Silviuu24/TUCN-Analog-Circuits-SCIA/Photo/Circuit.jpg

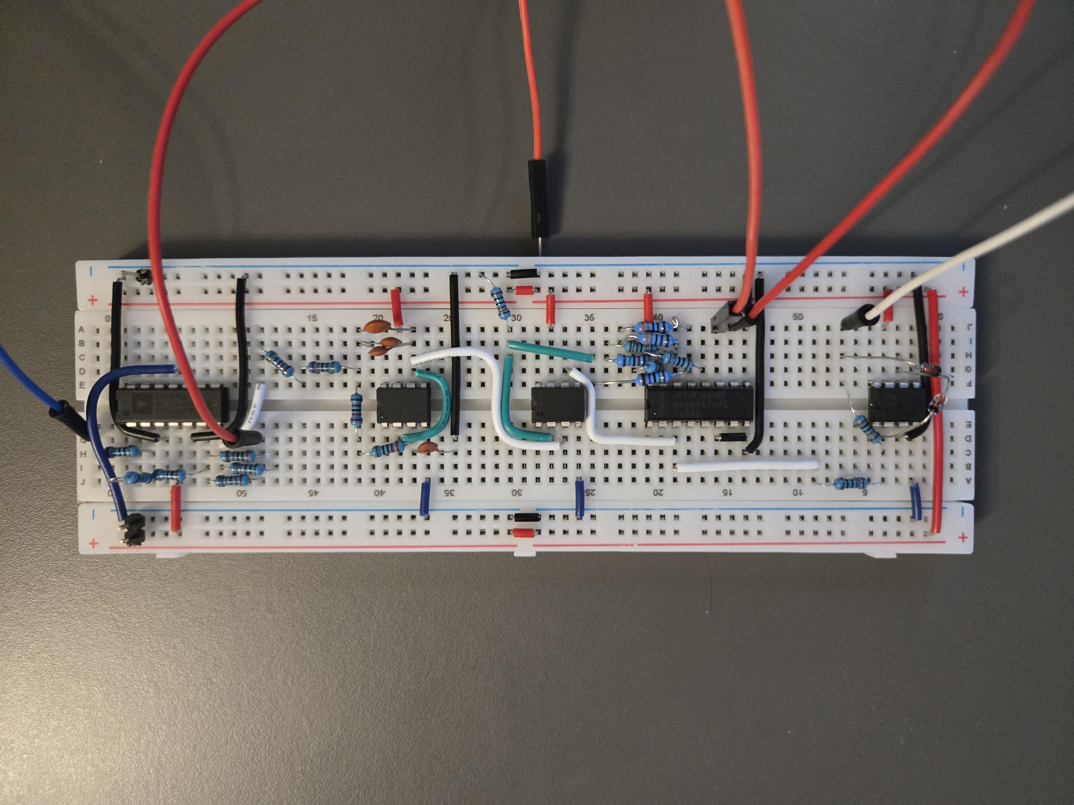
Photo/Circuit.jpg
