Silviuu24/TUCN-Analog-Circuits-SCIA/Docs/Proiect SCIA.pdf

# PROIECT SCIA

# SEMESTRUL I

2026

# Student: Șișca Silviu-Claudiu

Anul: III, 2133;

### Cuprins

## 1. Tematica proiectului

Să se proiecteze un circuit electric format din 4 etaje :

- Etajul 1 : - sursa de semnal este o sursă de tensiune diferențială
- amplitudinea minimă (pentru câștig maxim PGA): 0.116 [V]
- amplitudinea maximă (pentru câștig minim PGA): 0.232 [V]
- amplificator de instrumentație cu 2 AO , inversor
- câștigul etajului este 3
- Etajul 2 : - filtru Sallen-Key Low Pass
- câștigul liniar în banda de trecere este 1
- rezistența de intrare minimă este de 750 [Ω]
- banda filtrului este de 7000 [Hz]
- factorul de calitate Q este 1
- Etajul 3 : - amplificator cu câștig programabil, conexiune serie, neinversor
- câștigul minim este 8 [dB]
- rezoluția este 2 [dB]
- numărul de pași este 4
- câștigul maxim este 14 [dB]
- Etajul 4 : - redresor monoalternanță, alternanța pozitivă este amplificată
- câștigul etajului este 2

Pentru realizarea acestui circuit se vor folosi Amplificatoare Operaționale LT1679

## 2. Dimensionarea circuitului

### 2.1. Dimensionarea etajului 1

Etajul 1, ilustrat în figura 1, este un amplificator operațional cu alimentare diferențială. Trebuie dimensionate rezistențele R1, R2, R3, R4 și R5 pentru funcționarea corectă și pentru obținerea câștigului dorit.

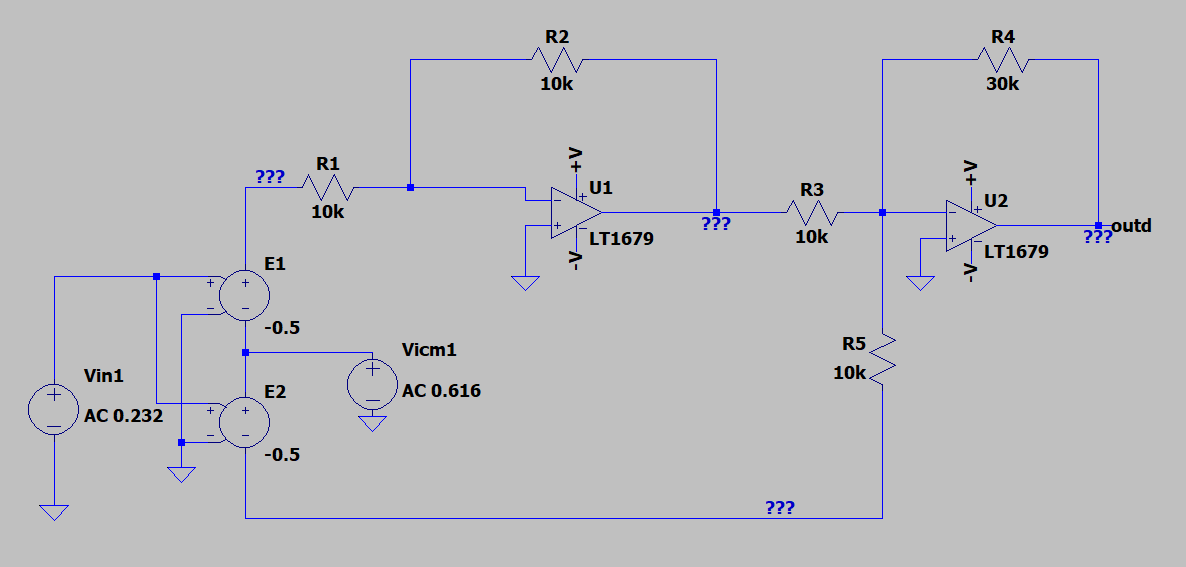
[picture p2: figure]

### Figura 1: Etajul 1 – Amplificatorul de instrumentație

Formula tensiunii de ieșire este reprezentată de relația (1).

Vout =

R2R4
R1R3

VA −

R4
R5

VB
(1)

Pentru ca circuitul să funcționeze ca amplificator de instrumentație trebuie respectate relațiile (2) și (3) rezultând relația (4).

Vout = AD(VA − VB) + Vref | (2)

RinA = RinB
RinA = R1
RinB = R5

(3)

R1 = R5
R2 = R3

(4)

Pentru a obține câștigul precizat, AD = 3 , rezistența R4 trebuie să fie de 3 ori mai mare decât rezistența R5.
R4 = 3R5
(4)

Alegem R5 = 10 kΩ și R2 = 10 kΩ.
Rezultă că R1 = R2 = R3 = R5 = 10 kΩ și R4 = 30 kΩ.

### 2.2. Dimensionarea etajului 2

Etajul 2, ilustrat în figura 2, este un filtru Sallen-Key Low Pass. Trebuie dimensionate rezistențele R1, R2 și condensatoarele C1, C2 .

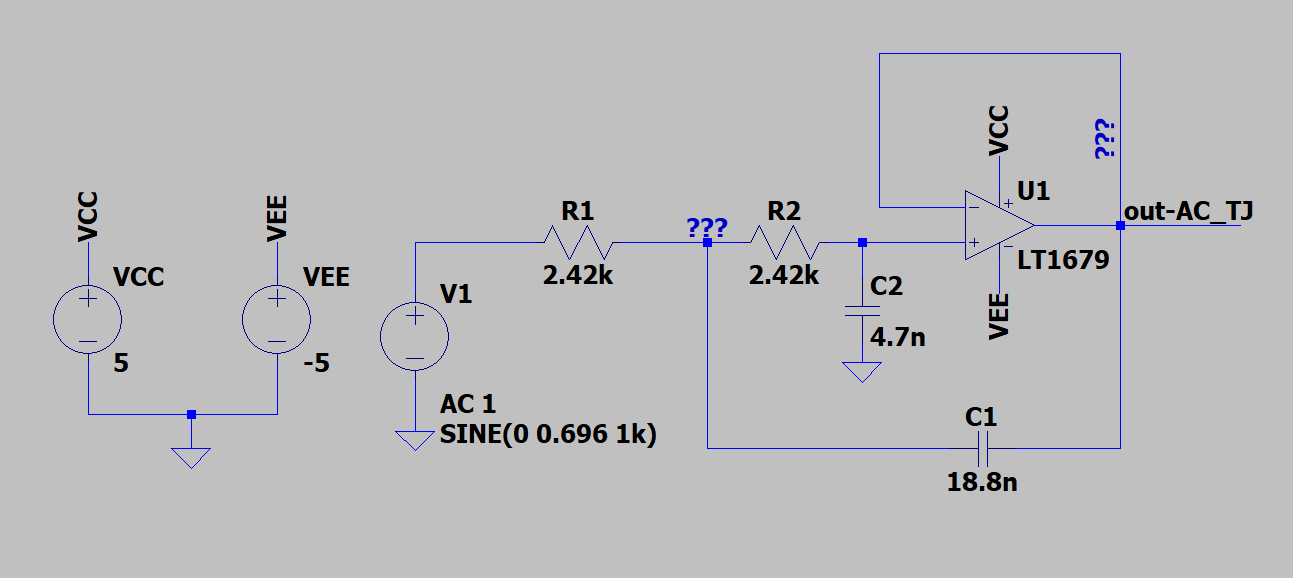
[picture p3: figure]

### Figura 2: Etajul 2 – Filtrul Sallen-Key Low Pass

Pentru dimensionarea circuitului, astfel încât să obținem câștig liniar în banda de trecere egal cu 1, banda de 7000 [Hz] și factorul de calitate Q egal cu 1, am folosit relațiile prezentate în figura 3.

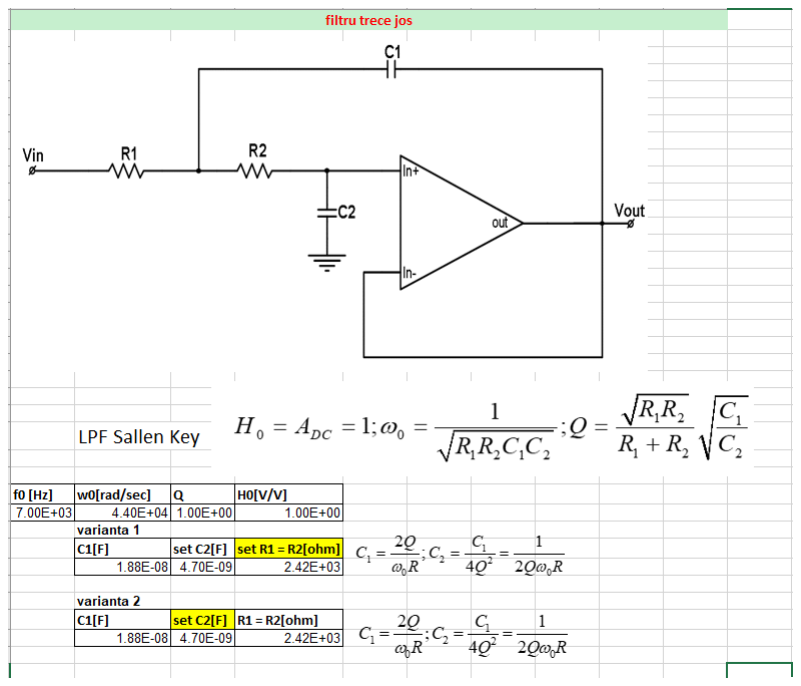
[picture p4: figure]

### Figura 3: Excel pentru dimensionarea etajului

Rezultă că C1 = 18.8 nF, C2 = 4.7 nF și R1 = R2 = 2.42 kΩ.

### 2.3. Dimensionarea etajului 3

Etajul 3, ilustrat în figura 4, este un amplificator cu câștig programabil (PGA), neinversor, conexiune serie, cu 4 variante de amplificare: 8dB, 10dB, 12dB și 14dB. Trebuie dimensionate rezistențele RF1, RF2, RF3, RF4 și RG.

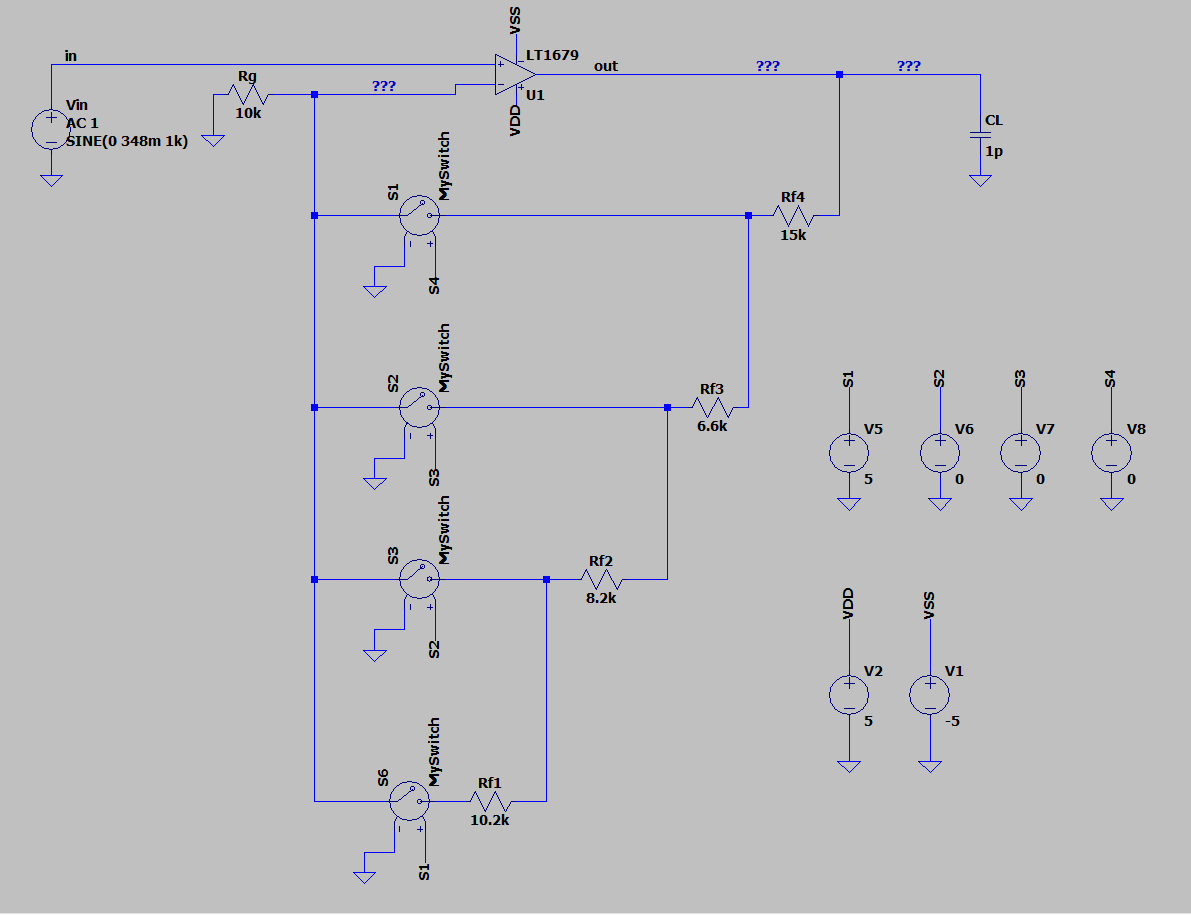
[picture p5: figure]

### Figura 4: Etajul 3 – PGA neinversor, conexiune serie

Formula generală a tensiunii de ieșire este reprezentată de relația (5).

Vout = (1 +

RF
RG
)Vin | (5)

Pentru cazul în care switch-ul de pe ramura cu RF1 este închis vom obține relația (6) și o amplificare AV = 14dB ≃ 5

Vout = (1 +

RF1 + RF2 + RF3 + RF4
RG
)Vin | (6)

Pentru cazul în care switch-ul de pe ramura cu RF2 este închis vom obține relația (7) și o amplificare AV = 12dB ≃ 3.98

Vout = (1 +

RF2 + RF3 + RF4
RG
)Vin | (7)

Pentru cazul în care switch-ul de pe ramura cu RF3 este închis vom obține relația (8) și o amplificare AV = 10dB ≃ 3.16

Vout = (1 +

RF3 + RF4
RG
)Vin | (8)

Pentru cazul în care switch-ul de pe ramura cu RF4 este închis vom obține relația (9) și o amplificare AV = 8dB ≃ 2.5

Vout = (1 +

RF4
RG
)Vin | (9)

Egalând formulele ampificărilor cu valorile corespunzătoare rezultă:

1 +

RF4
RG

= 2.5

1 +

RF3 + RF4
RG

= 3.16

1 +

RF2+RF3 + RF4
RG

= 3.98

1 +

RF1 + RF2 + RF3 + RF4
RG

= 5

(10)

Din relațiile de la (10) putem găsi valorile rezistențelor RF1, RF2, RF3 și RF4 în funcție de RG.

RF4 = 1.5RG

RF3 = 0.66RG

RF2 = 0.82RG

RF1 = 1.02RG

(11)

Alegem RG = 10 kΩ .
Rezultă că RF1 = 10.2 kΩ, RF2 = 8.2 kΩ, RF3 = 6.6 kΩ, RF4 = 15 kΩ.

### 2.4. Dimensionarea etajului 4

Etajul 4, ilustrat în figura 5, este un redresor monoalternanță care amplifică alternanța pozitivă. Trebuie dimensionate rezistențele R1 și R2 pentru a obține un câștig AV egal cu 2.

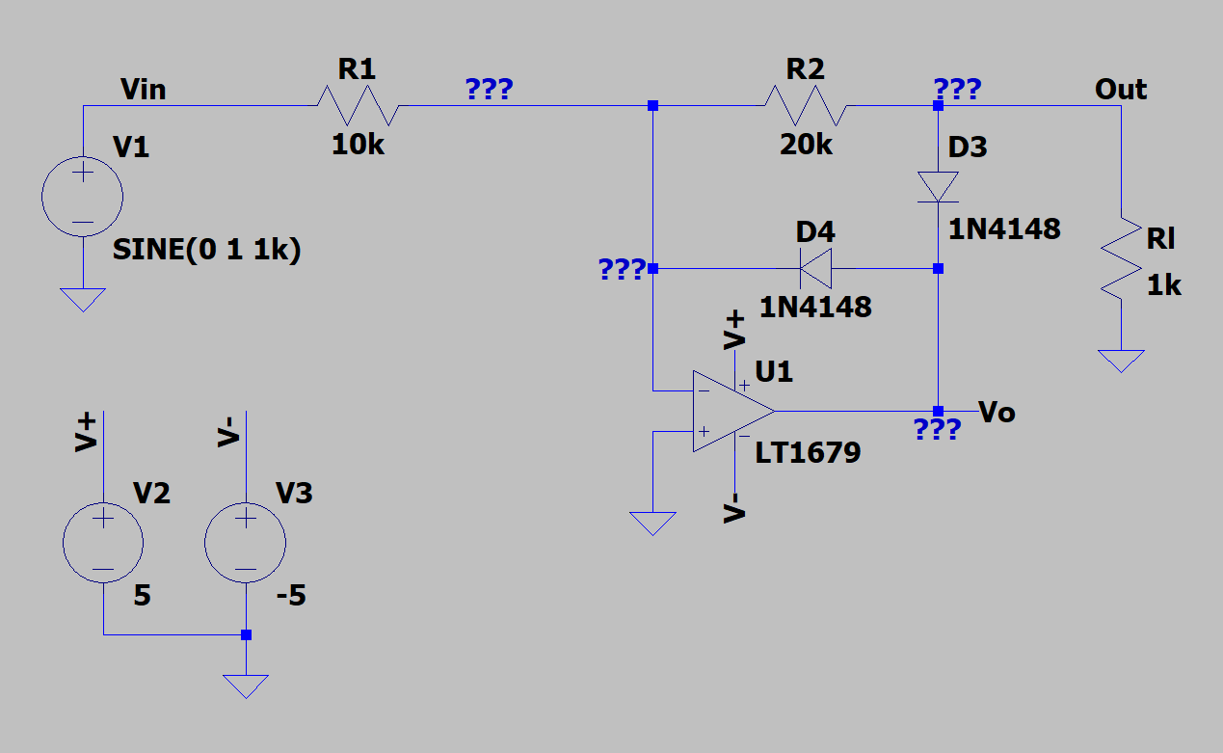
[picture p6: figure]

### Figura 5: Etajul 4 – Redresor monoalternanță

Formula tensiunii de ieșire, Vout, când tensiunea de intrare este negativă, Vin ≤ 0, este reprezentată de relația (12).

Vout = 0
(12)

Formula tensiunii de ieșire, Vout, când tensiunea de intrare este pozitivă, Vin > 0, este reprezentată de relația (13).

Vout = −

R2
R1
Vin | (13)

Egalând modulul amplificării din relația (13) cu amplificarea dorită se obține:

R2 = 2R1
(13)

Alegem R1 = 10 kΩ .
Rezultă că R2 = 20 kΩ .

## 3. Caracterizarea circuitului

### 3.1. Caracterizarea etajului 1

### 3.1.1. Punctul static de funcționare

Această simulare ne va arăta starea circuitului la repaus (nu avem semnal de intrare).
În figurile 6 și 7 se observă că, în absența semnalului de intrare, Vin = 0V, tensiunea de ieșire Vout este neglijabilă (2.24 µV), fiind cauzată doar de tensiunea mică de offset a amplificatorului real LT1679. Rezultă că etajul este polarizat corect și nu este saturat.

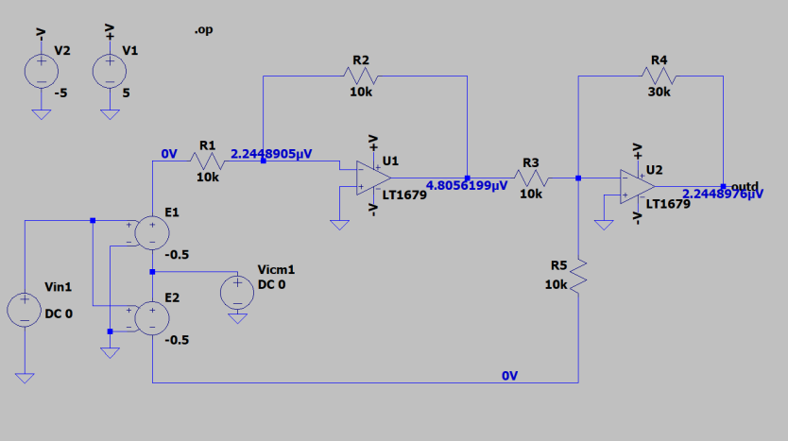
[picture p7: figure]

### Figura 6: Analiza .op asupra circuitului

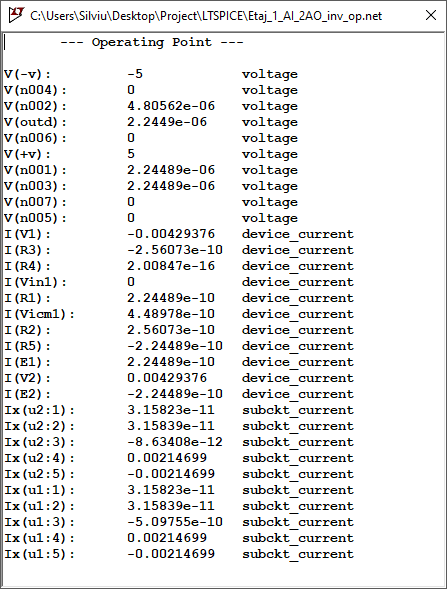
[picture p8: figure]

### Figura 7: Rezultatele analizei .op

### 3.1.2. Analiza AC – câstigul la joasă frecvență, banda, CMRR, PSRR

Cu ajutorul acestei simulări vom putea genera diagramele Bode.
Sintaxa pe care o vom folosi este: “.ac dec 100 .01 10Meg” .

Din figurile 8 și 9 putem afla că: banda etajului este de aproximativ 1.42MHz fiind mult mai mare decât banda filtrului (7kHz), câștigul la joasă frecvență este de aproximativ 9.54dB, adică aproximativ 3.

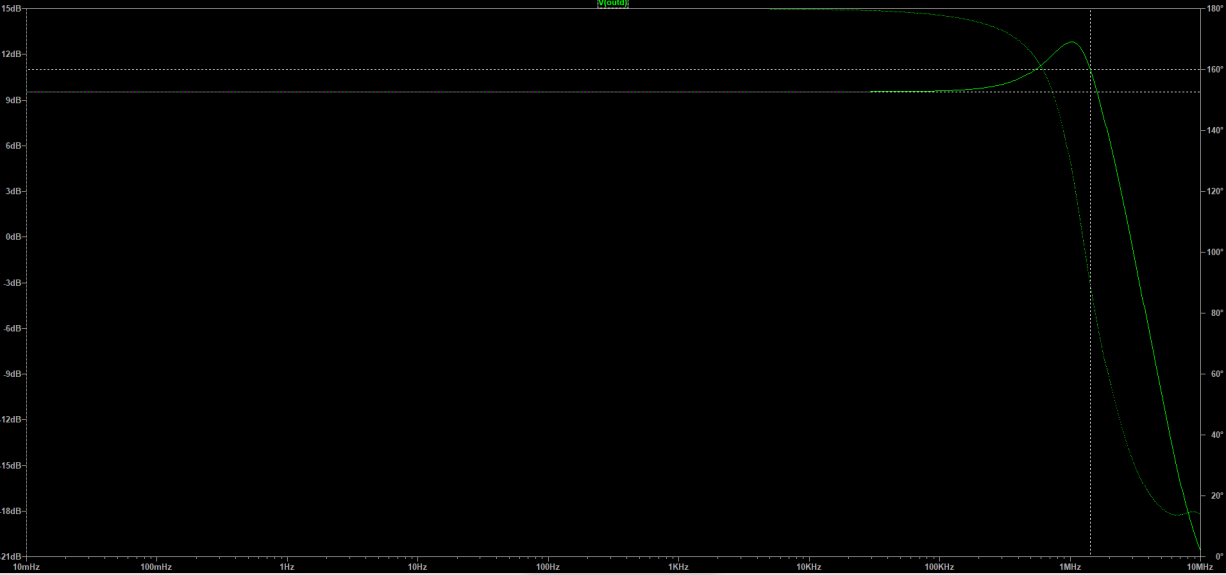
[picture p9: figure]

### Figura 8: Diagrama Bode a etajului

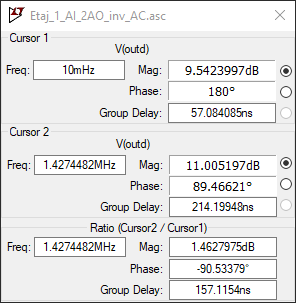
[picture p10: figure]

### Figura 9: Tabelul valorilor pentru cursoare

Pentru a afla CMRR-ul vom folosi circuitul din figura 10.
Din figurile 11 și 12 putem extrage că: CMRR-ul este 109dB la joasă frecvență și aproximativ 48dB la frecvența de 10kHz.

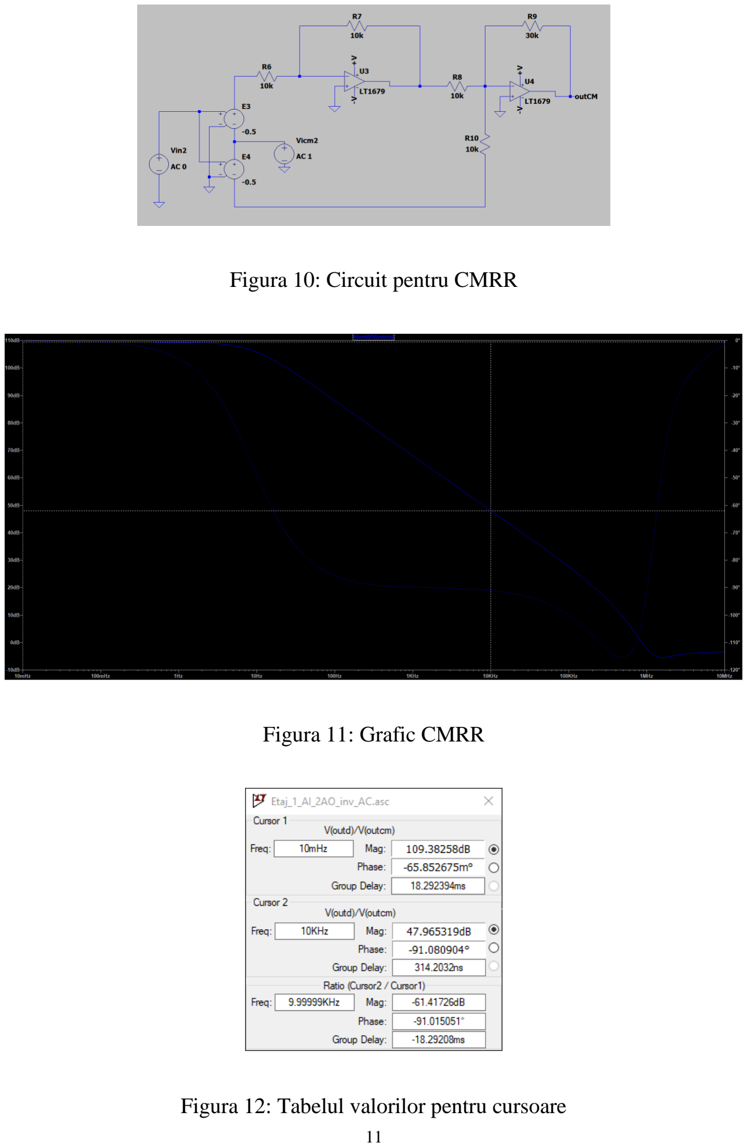
[picture p11: page 11]

### Figura 10: Circuit pentru CMRR

### Figura 11: Grafic CMRR

### Figura 12: Tabelul valorilor pentru cursoare

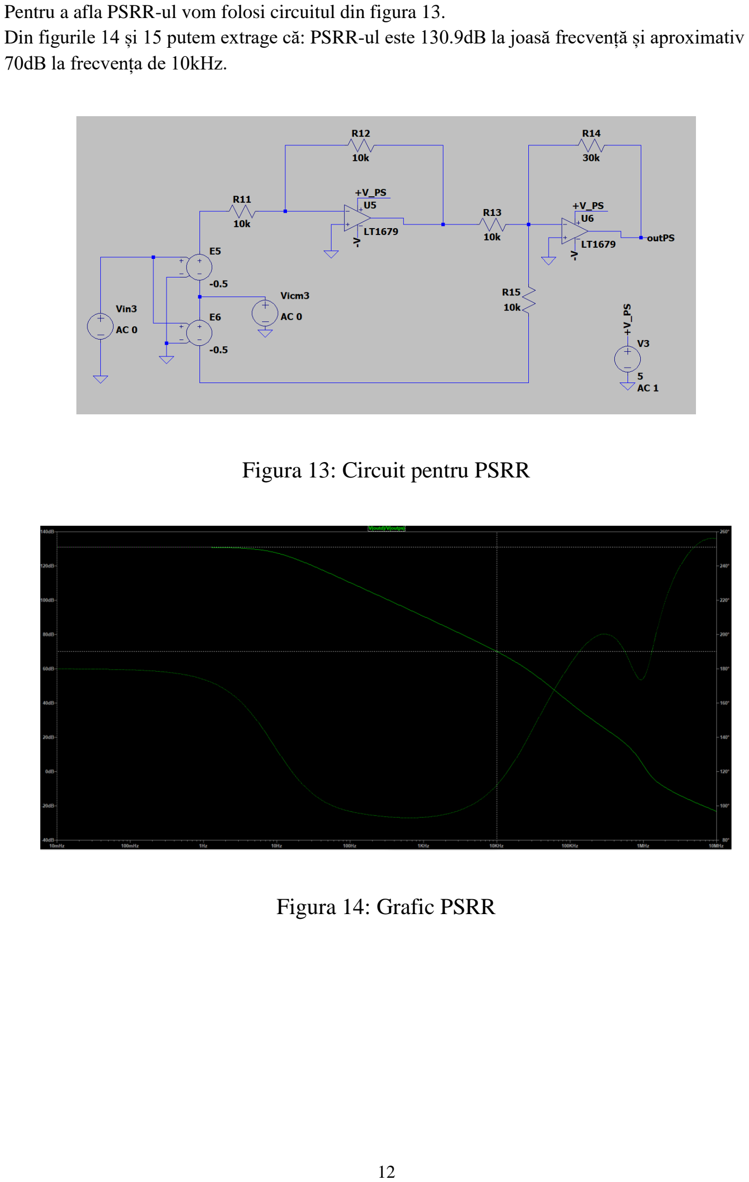
[picture p12: page 12]

Pentru a afla PSRR-ul vom folosi circuitul din figura 13.
Din figurile 14 și 15 putem extrage că: PSRR-ul este 130.9dB la joasă frecvență și aproximativ 70dB la frecvența de 10kHz.

### Figura 13: Circuit pentru PSRR

### Figura 14: Grafic PSRR

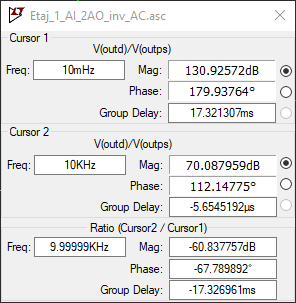
[picture p13: figure]

### Figura 15: Tabelul valorilor pentru cursoare

### 3.1.3. Analiza Transient – SR, liniaritate

Această simulare permite analiza formei de undă a semnalului de ieșire în domeniul timp. Sintaxa pe care o vom folosi este: “.tran 0 10m 0 0.1m” .

În figura 16 aflăm că THD ≃ 0.805% .

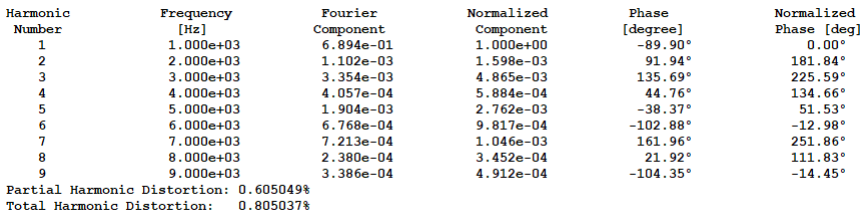
[picture p14: figure]

### Figura 16: Tabel analiză Fourier

În figura 17 putem observa semnalul de intrare Vin în comparație cu semnalul de ieșire Vout, care este inversat și amplificat cu un AV ≃ 3 .

Liniaritatea circuitului este confirmată prin analiza Fourier, prin faptul că semnalul de ieșire este o copie fidelă a semnalului de intrare, fiind amplificat si inversat.

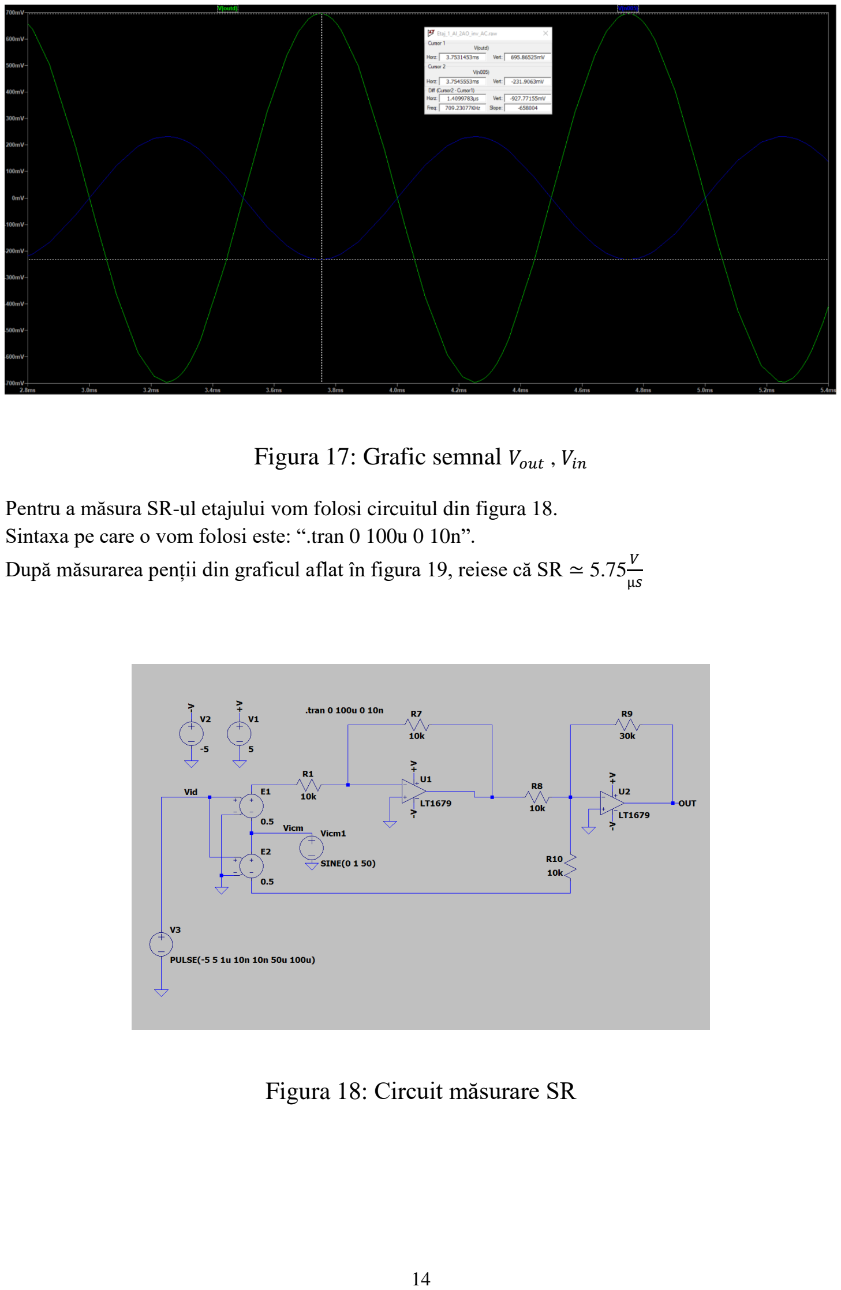
[picture p15: page 14]

### Figura 17: Grafic semnal Vout , Vin

Pentru a măsura SR-ul etajului vom folosi circuitul din figura 18.
Sintaxa pe care o vom folosi este: “.tran 0 100u 0 10n”.
După măsurarea penții din graficul aflat în figura 19, reiese că SR ≃ 5.75 V
µs

### Figura 18: Circuit măsurare SR

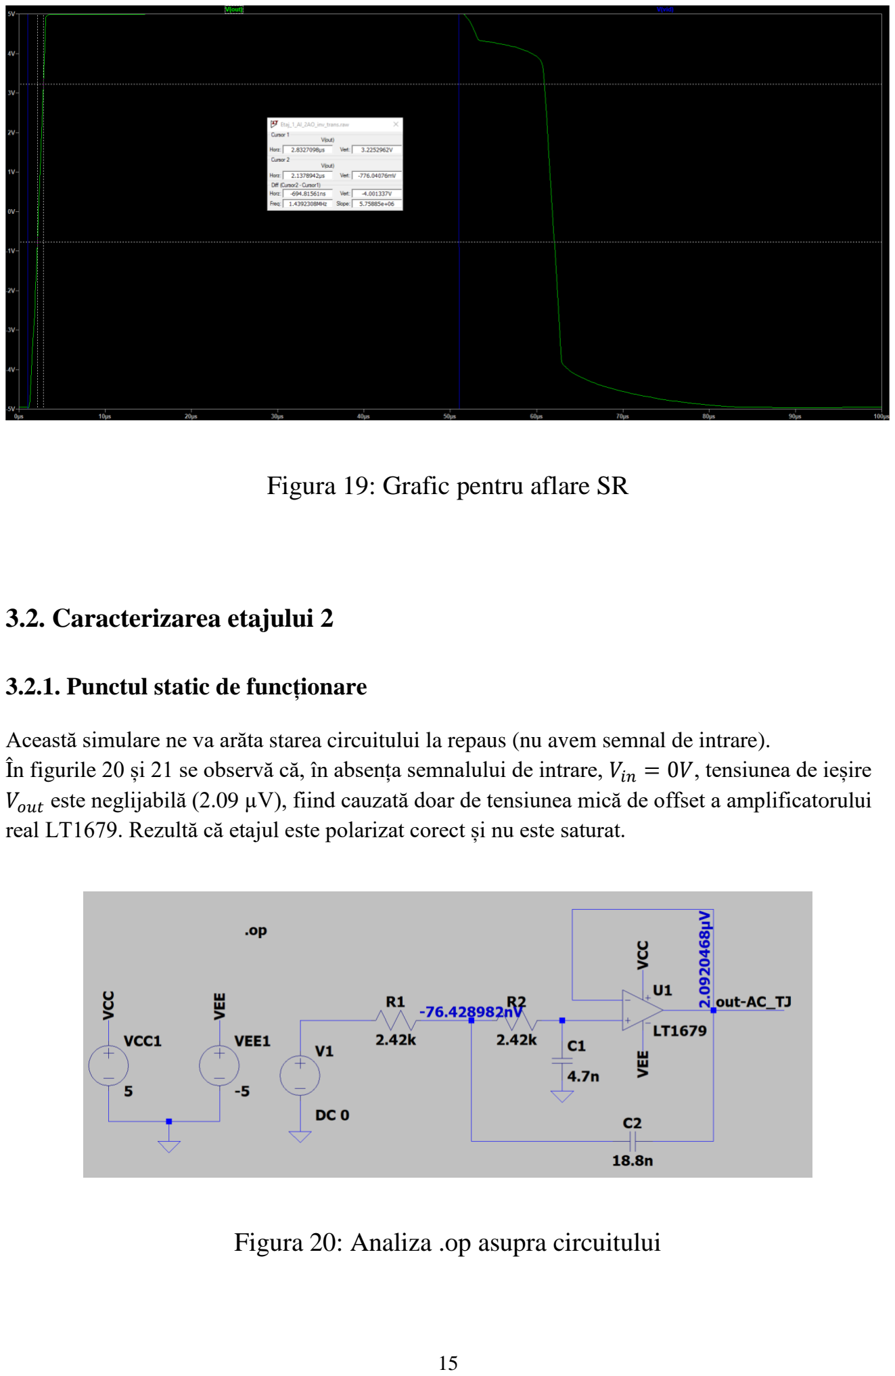
[picture p16: page 15]

### Figura 19: Grafic pentru aflare SR

### 3.2. Caracterizarea etajului 2

### 3.2.1. Punctul static de funcționare

Această simulare ne va arăta starea circuitului la repaus (nu avem semnal de intrare).
În figurile 20 și 21 se observă că, în absența semnalului de intrare, Vin = 0V, tensiunea de ieșire Vout este neglijabilă (2.09 µV), fiind cauzată doar de tensiunea mică de offset a amplificatorului real LT1679. Rezultă că etajul este polarizat corect și nu este saturat.

### Figura 20: Analiza .op asupra circuitului

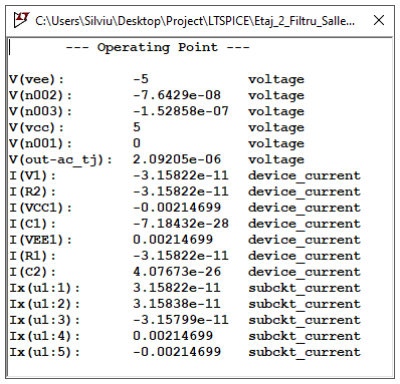
[picture p17: figure]

### Figura 21: Rezultatele analizei .op

### 3.2.2. Analiza AC – câstigul la joasă frecvență, banda

Cu ajutorul acestei simulări vom putea genera diagramele Bode.
Sintaxa pe care o vom folosi este: “.ac oct 100 1 10k” .

Din figurile 22 și 23 putem afla că: banda filtrului este de 7kHz, câștigul în banda de trecere îl putem considera 0dB pe marea majoritate a benzii , acesta având un maxim de 1.2dB la frecvența de 5kHz. Acest maxim este datorat factorului de calitate Q = 1.

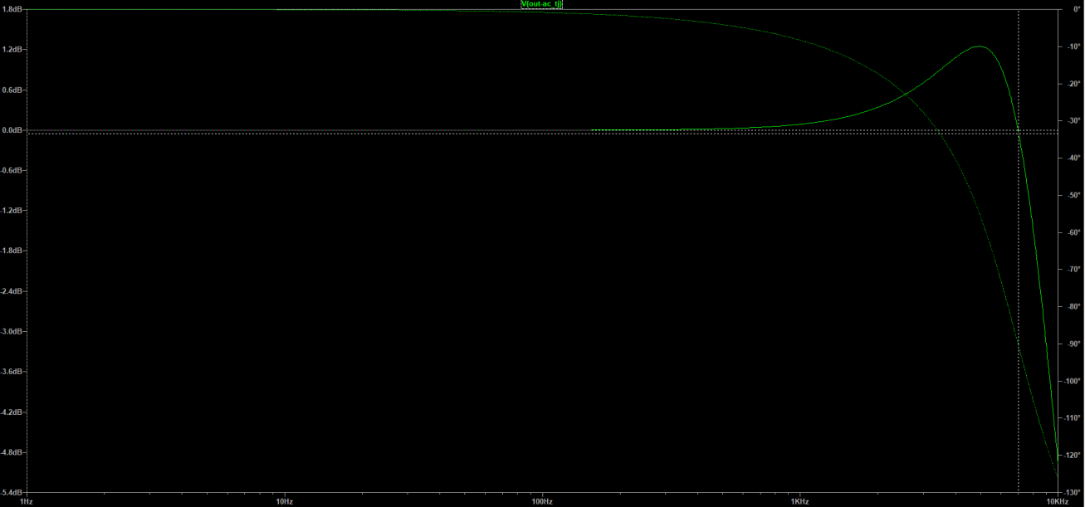
[picture p18: figure]

### Figura 22: Diagrama Bode a filtrului

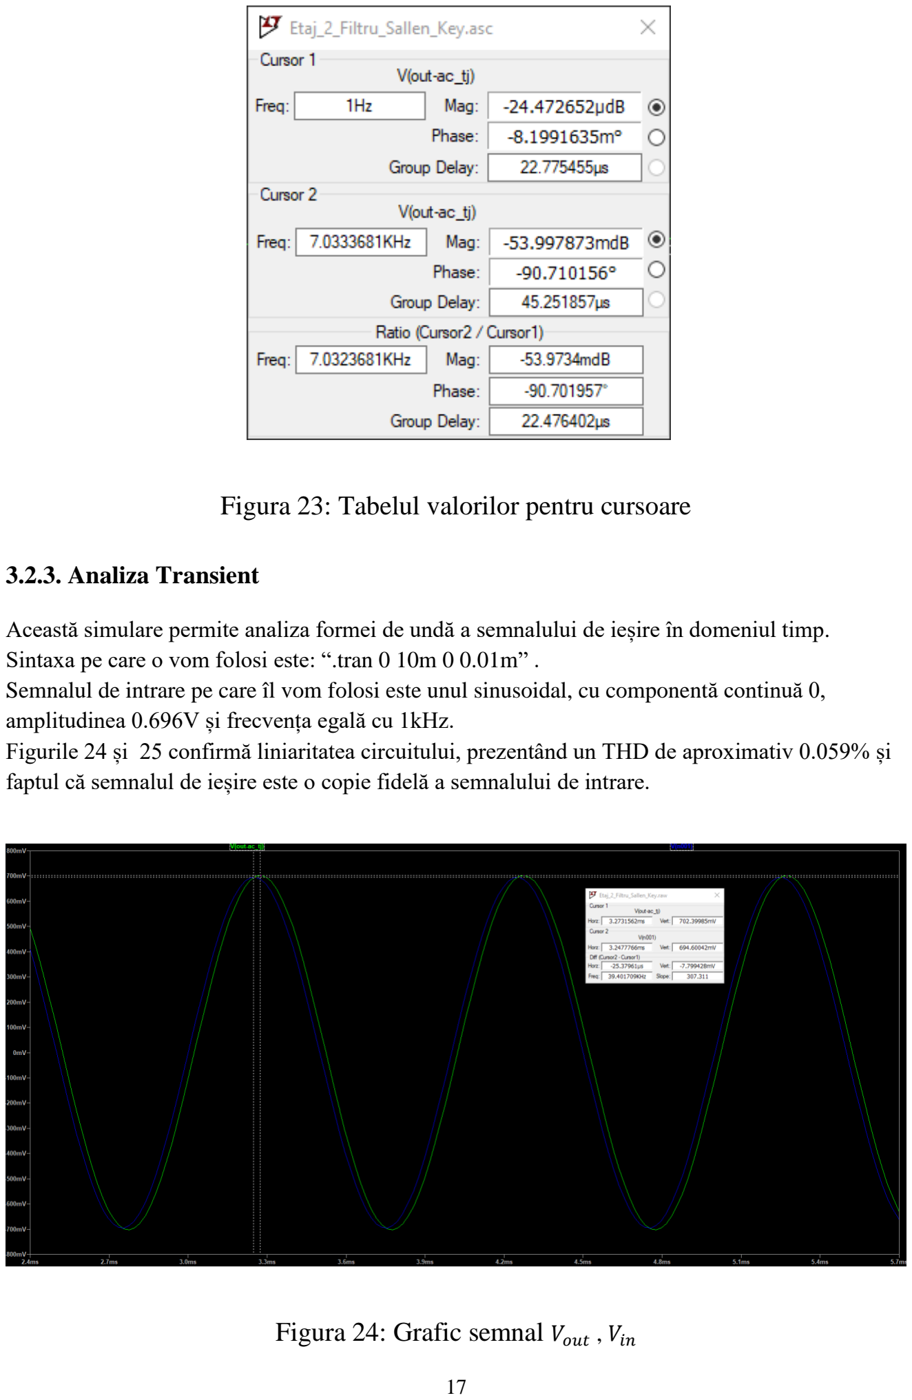
[picture p19: page 17]

### Figura 23: Tabelul valorilor pentru cursoare

### 3.2.3. Analiza Transient

Această simulare permite analiza formei de undă a semnalului de ieșire în domeniul timp. Sintaxa pe care o vom folosi este: “.tran 0 10m 0 0.01m” .
Semnalul de intrare pe care îl vom folosi este unul sinusoidal, cu componentă continuă 0, amplitudinea 0.696V și frecvența egală cu 1kHz.
Figurile 24 și 25 confirmă liniaritatea circuitului, prezentând un THD de aproximativ 0.059% și faptul că semnalul de ieșire este o copie fidelă a semnalului de intrare.

### Figura 24: Grafic semnal Vout , Vin

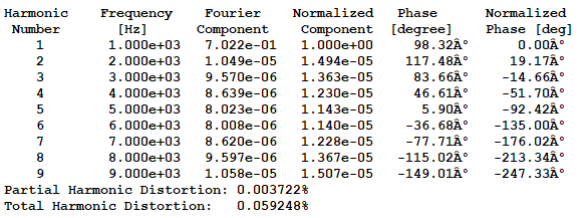
[picture p20: figure]

### Figura 25: Tabel analiză Fourier

### 3.3. Caracterizarea etajului 3

### 3.3.1. Punctul static de funcționare

Această simulare ne va arăta starea circuitului la repaus (nu avem semnal de intrare).
În figura 26 se observă că, în absența semnalului de intrare, Vin = 0V, și când Switch-ul 1 este închis, tensiunea de ieșire Vout este 12 µV.
În figura 27 se observă că, în absența semnalului de intrare, Vin = 0V, și când Switch-ul 4 este închis, tensiunea de ieșire Vout este 6 µV.
Aceste tensiuni sunt neglijabile și sunt cauzate doar de tensiunea mică de offset a amplificatorului real LT1679. Rezultă că etajul este polarizat corect și nu este saturat.

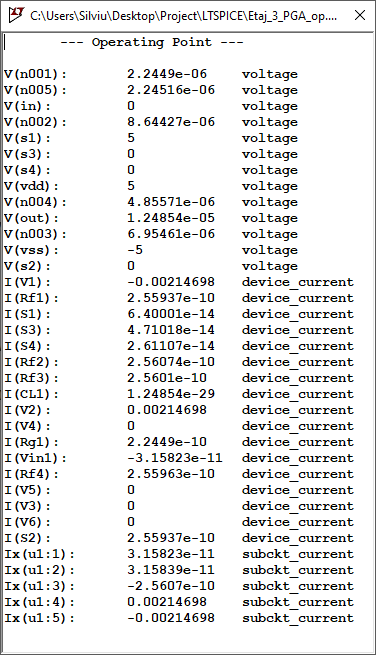
[picture p21: figure]

### Figura 26: Rezultatele analizei .op când switch-ul 1 este închis

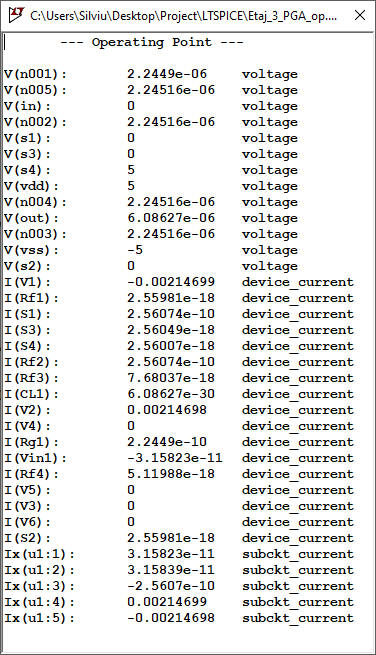
[picture p22: figure]

### Figura 27: Rezultatele analizei .op când switch-ul 4 este închis

### 3.3.2. Analiza AC

Această simulare va genera diagrama Bode, reprezentată în figura 28, pentru cele 4 cazuri de câștig a PGA-ului.
Vom obține câștiguri de 8dB, 10dB, 12dB respectiv 14dB, așa cum reiese din figurile 29, 30, 31 respectiv 32.

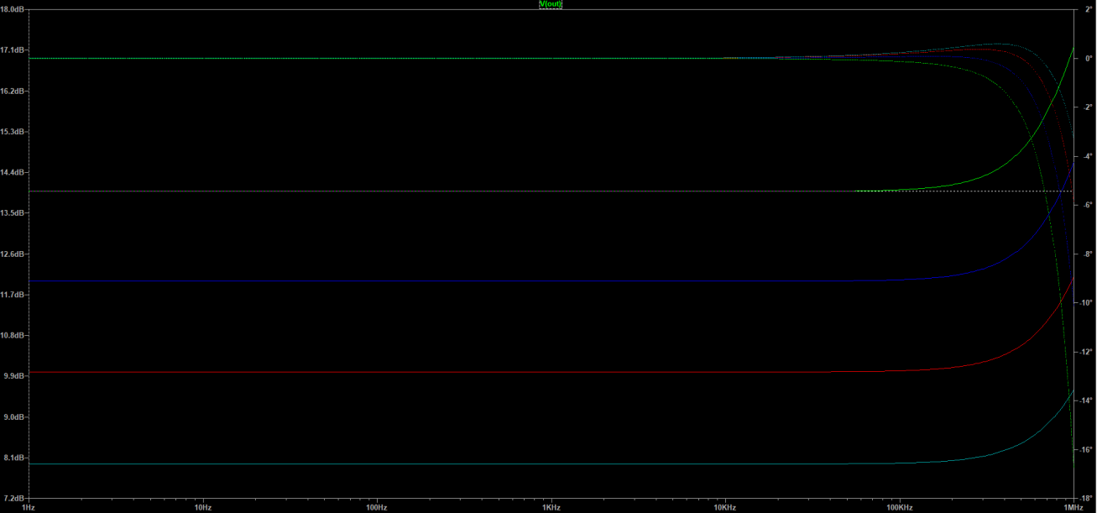
[picture p23: figure]

### Figura 28: Diagrama Bode PGA

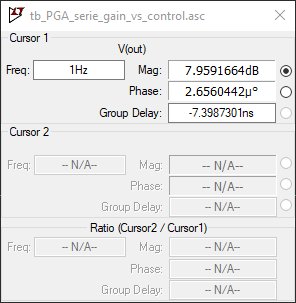
[picture p24: figure]

### Figura 29: Câștig PGA – Switch 4 ON

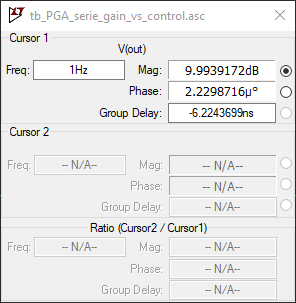
[picture p25: figure]

### Figura 30: Câștig PGA – Switch 3 ON

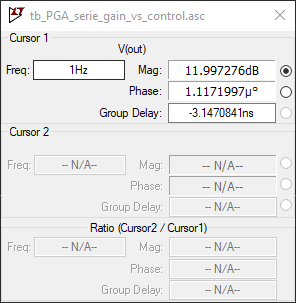
[picture p26: figure]

### Figura 31: Câștig PGA – Switch 2 ON

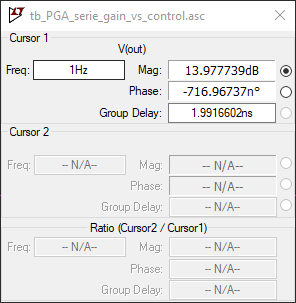
[picture p27: figure]

### Figura 32: Câștig PGA – Switch 1 ON

Pentru a afla banda PGA-ului pentru fiecare câștig vom realiza o analiză AC, folosind sintaxa: “.ac dec 100 1 10Meg” .

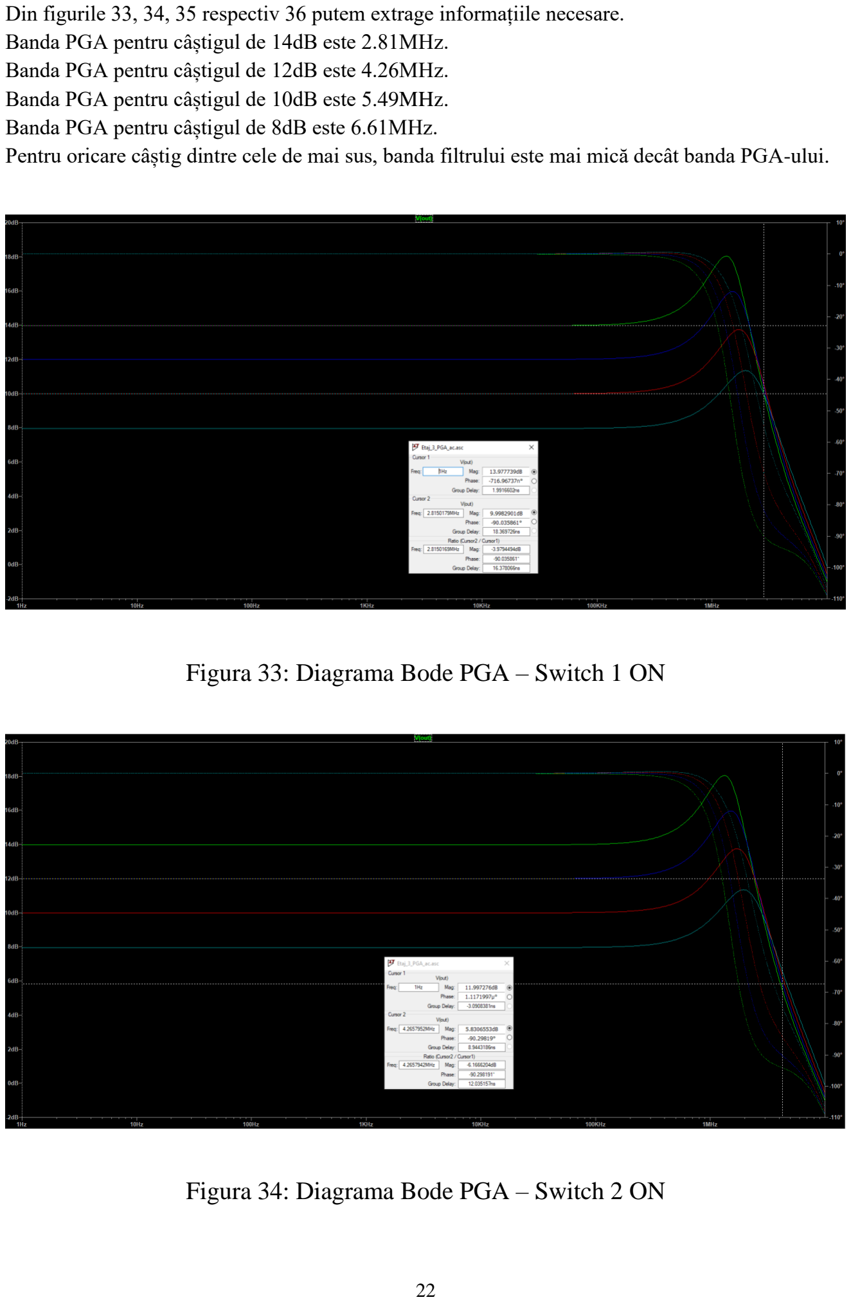
[picture p28: page 22]

Din figurile 33, 34, 35 respectiv 36 putem extrage informațiile necesare. Banda PGA pentru câștigul de 14dB este 2.81MHz.
Banda PGA pentru câștigul de 12dB este 4.26MHz.
Banda PGA pentru câștigul de 10dB este 5.49MHz.
Banda PGA pentru câștigul de 8dB este 6.61MHz.
Pentru oricare câștig dintre cele de mai sus, banda filtrului este mai mică decât banda PGA-ului.

### Figura 33: Diagrama Bode PGA – Switch 1 ON

### Figura 34: Diagrama Bode PGA – Switch 2 ON

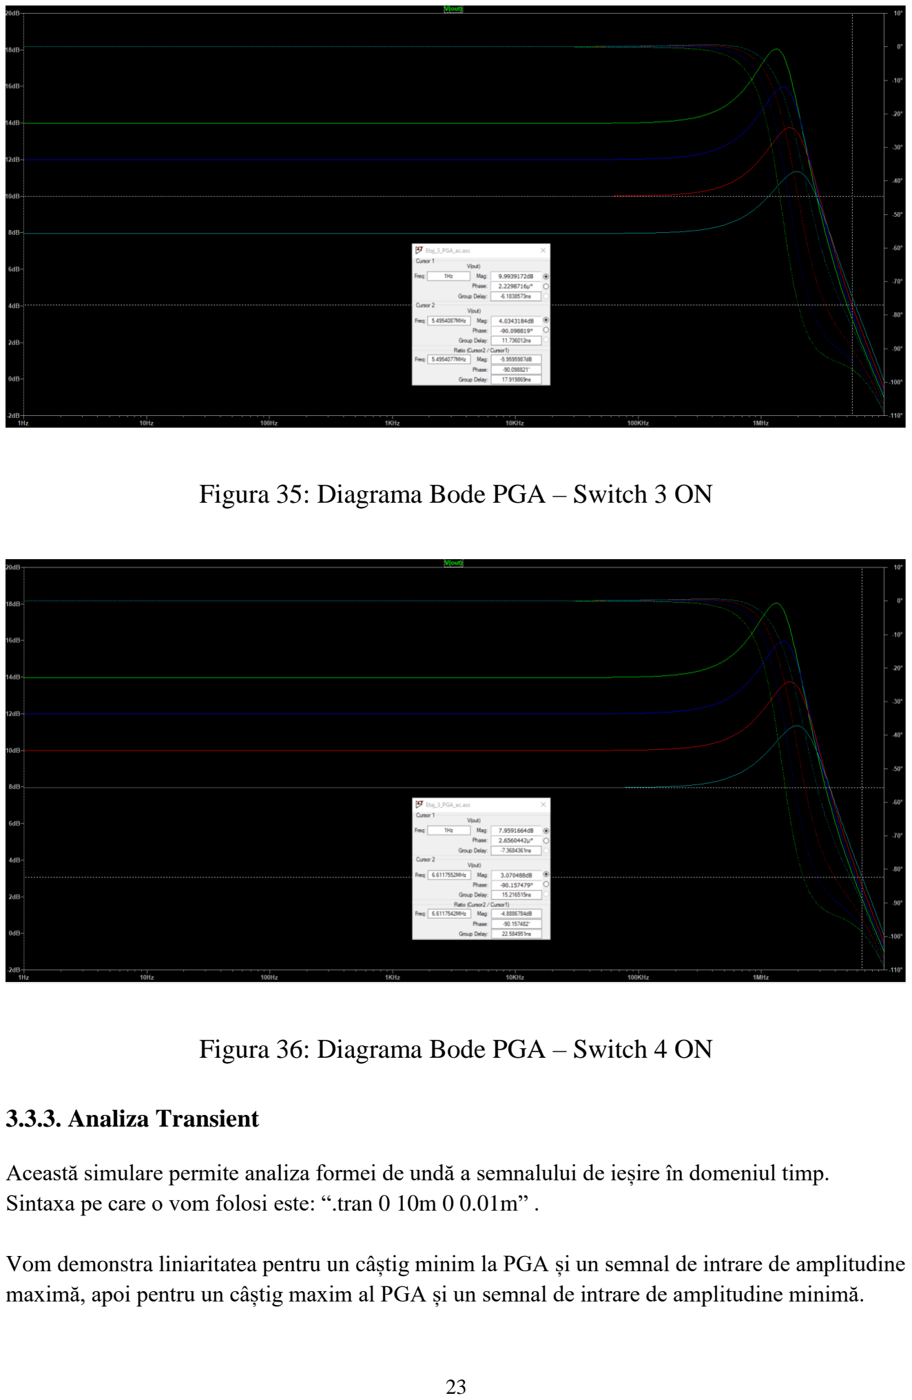
[picture p29: page 23]

### Figura 35: Diagrama Bode PGA – Switch 3 ON

### Figura 36: Diagrama Bode PGA – Switch 4 ON

### 3.3.3. Analiza Transient

Această simulare permite analiza formei de undă a semnalului de ieșire în domeniul timp. Sintaxa pe care o vom folosi este: “.tran 0 10m 0 0.01m” .

Vom demonstra liniaritatea pentru un câștig minim la PGA și un semnal de intrare de amplitudine maximă, apoi pentru un câștig maxim al PGA și un semnal de intrare de amplitudine minimă.

În primul caz, semnalul de intrare pe care îl vom folosi este unul sinusoidal, cu componentă continuă 0, amplitudinea 0.348V și frecvența egală cu 1kHz. PGA-ul va avea amplificarea maximă de 14dB, adică Switch 1 ON.
Figurile 37 și 38 confirmă liniaritatea circuitului, prezentând un THD de aproximativ 0.059% și faptul că semnalul de ieșire este o copie fidelă a semnalului de intrare.
Semnalul de ieșire va avea o amplitudine de aproximativ 1.74V .

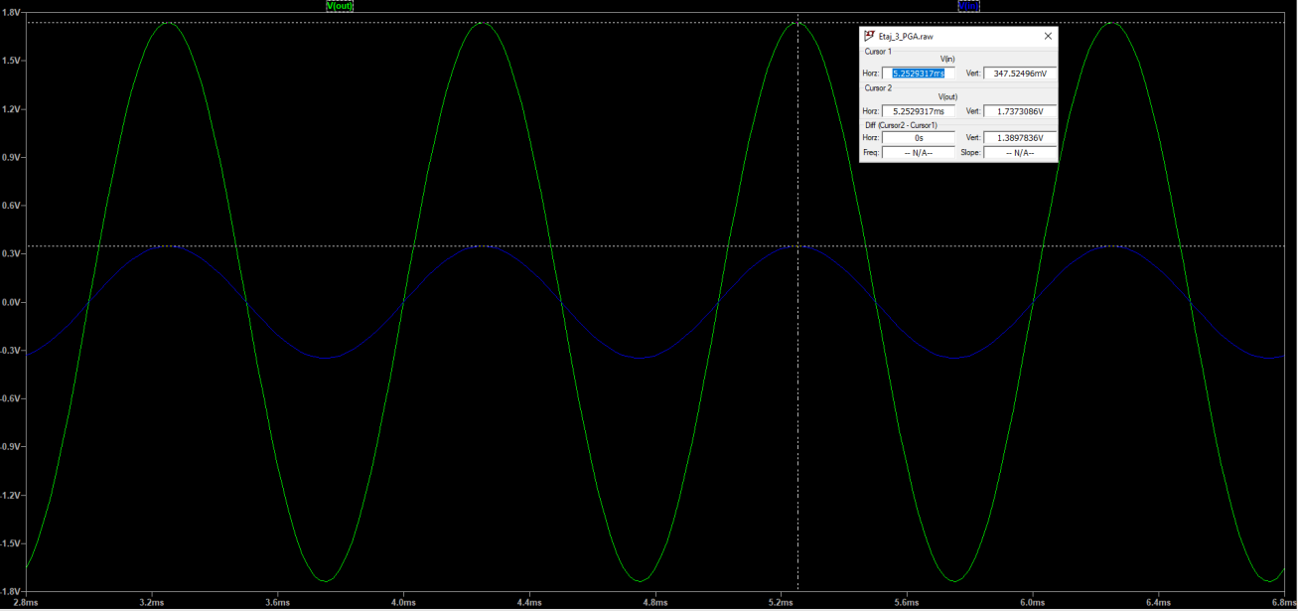
[picture p30: figure]

### Figura 37: Grafic semnal Vout , Vin

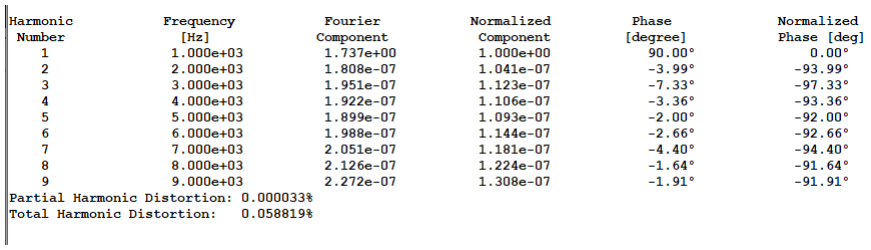
[picture p31: figure]

### Figura 38: Tabel analiză Fourier

În al doilea caz, semnalul de intrare pe care îl vom folosi este unul sinusoidal, cu componentă continuă 0, amplitudinea 0.696V și frecvența egală cu 1kHz. PGA-ul va avea amplificarea minimă de 8dB, adică Switch 4 ON.
Figurile 39 și 40 confirmă liniaritatea circuitului, prezentând un THD de aproximativ 0.059% și faptul că semnalul de ieșire este o copie fidelă a semnalului de intrare.
Semnalul de ieșire va avea o amplitudine de aproximativ 1.74V .

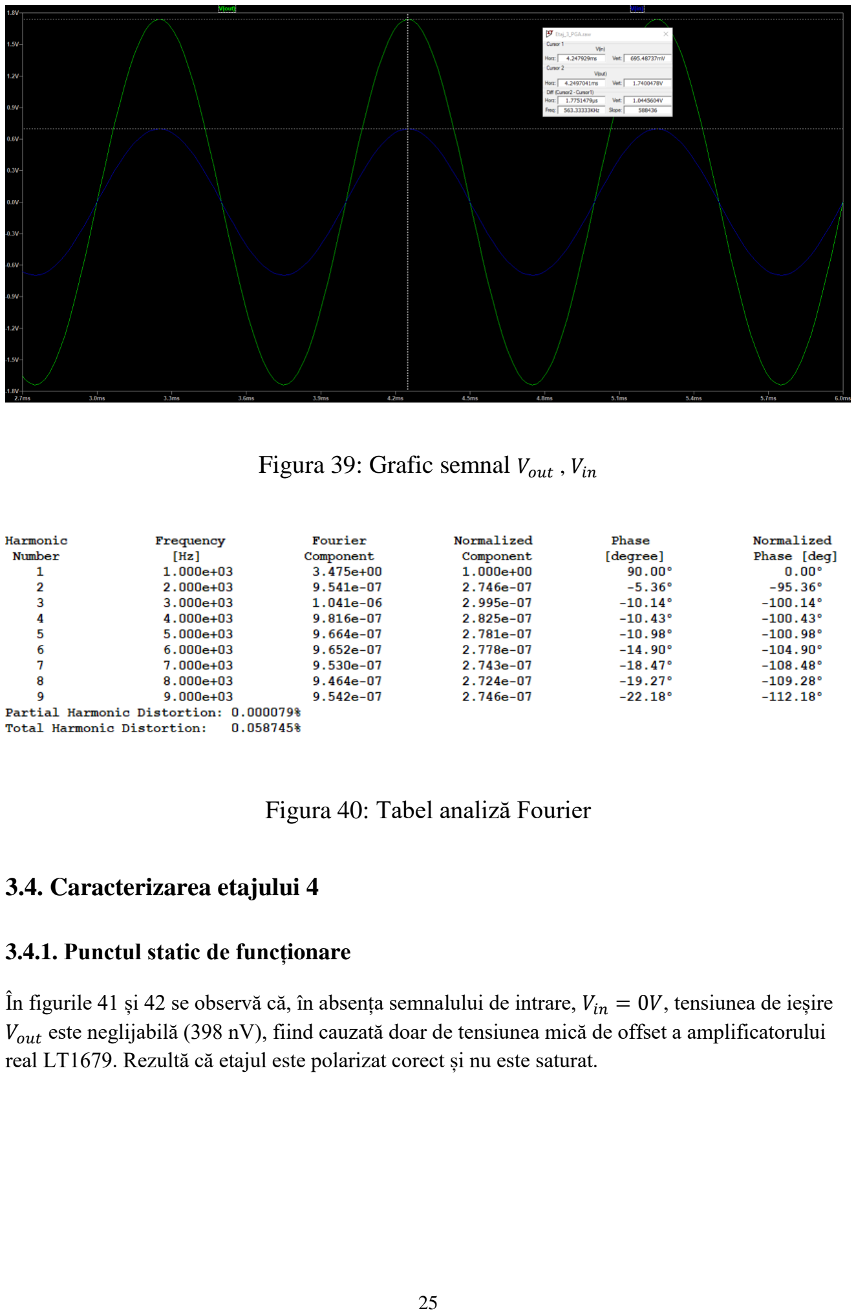
[picture p32: page 25]

### Figura 39: Grafic semnal Vout , Vin

### Figura 40: Tabel analiză Fourier

### 3.4. Caracterizarea etajului 4

### 3.4.1. Punctul static de funcționare

În figurile 41 și 42 se observă că, în absența semnalului de intrare, Vin = 0V, tensiunea de ieșire Vout este neglijabilă (398 nV), fiind cauzată doar de tensiunea mică de offset a amplificatorului real LT1679. Rezultă că etajul este polarizat corect și nu este saturat.

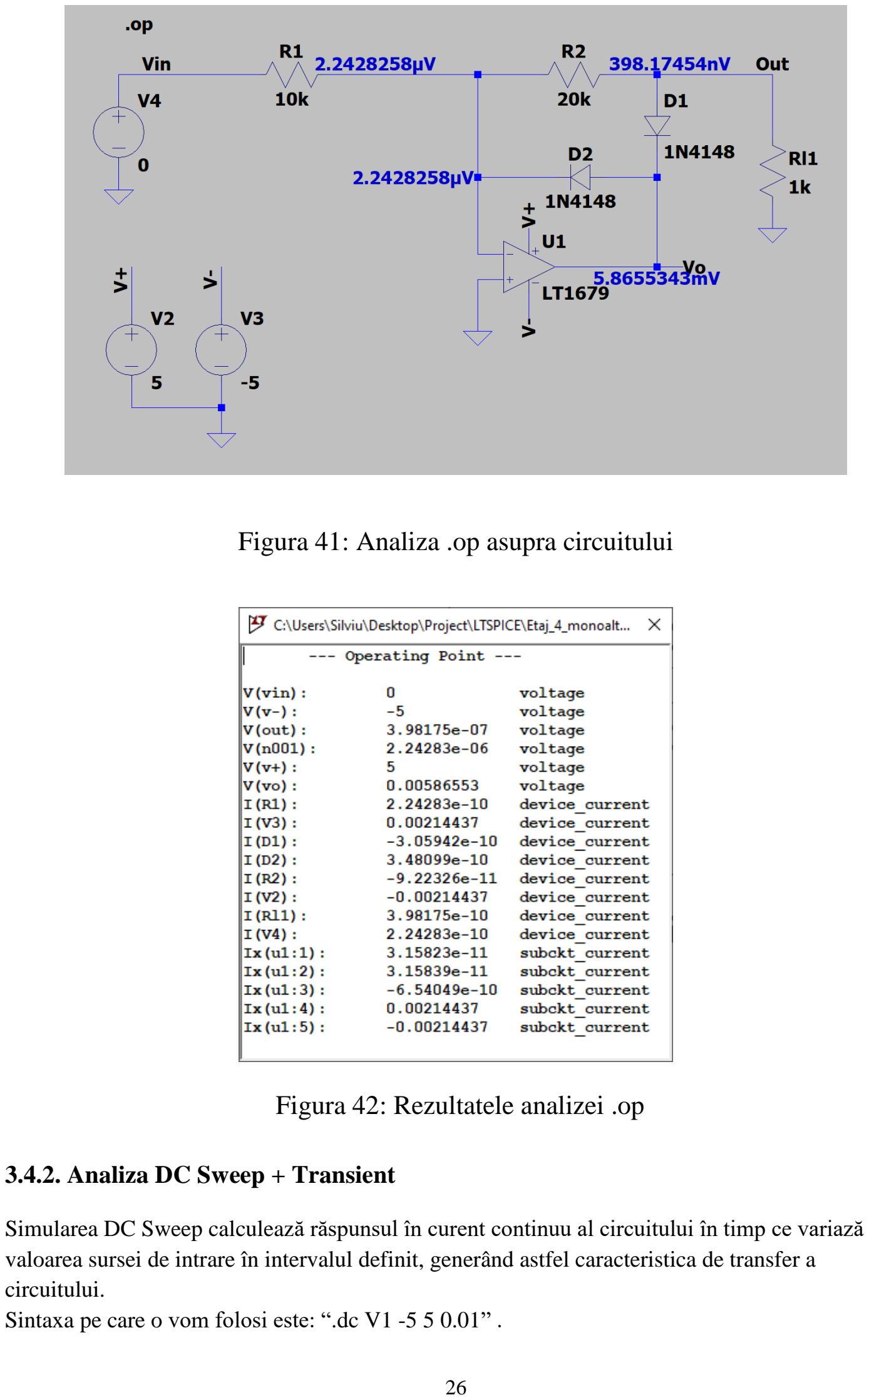
[picture p33: page 26]

### Figura 41: Analiza .op asupra circuitului

### Figura 42: Rezultatele analizei .op

### 3.4.2. Analiza DC Sweep + Transient

Simularea DC Sweep calculează răspunsul în curent continuu al circuitului în timp ce variază valoarea sursei de intrare în intervalul definit, generând astfel caracteristica de transfer a circuitului.
Sintaxa pe care o vom folosi este: “.dc V1 -5 5 0.01” .

Panta graficului din figura 43 este -2, deci pentru alternanța pozitivă a semnalului de intrare, semnalul de ieșire este inversat si amplificat cu 2.

Din figura 43 putem observa că domeniul de funționare a circuitului este mai mare decât amplitudinea de intrare maximă din etajul anterior (2.2V > 1.74V ).

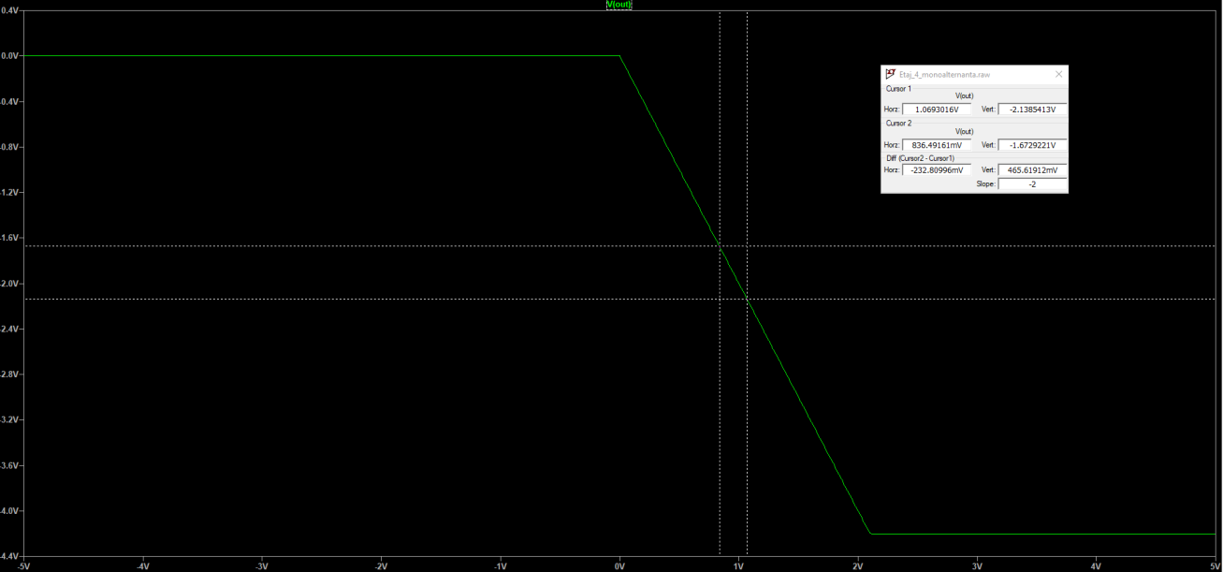
[picture p34: figure]

### Figura 43: Caracteristica de transfer a circuitului

Simularea Transient permite analiza formei de undă a semnalului de ieșire în domeniul timp. Sintaxa pe care o vom folosi este: “.tran 0 4m 0 0.01” .

În figura 44 putem observa că pentru alternanța negativă a semnalului de intrare, semnalul de ieșire este 0, iar pentru alternanța pozitivă a semnalului de intrare, semnalul de ieșire este inversat și amplificat cu 2.

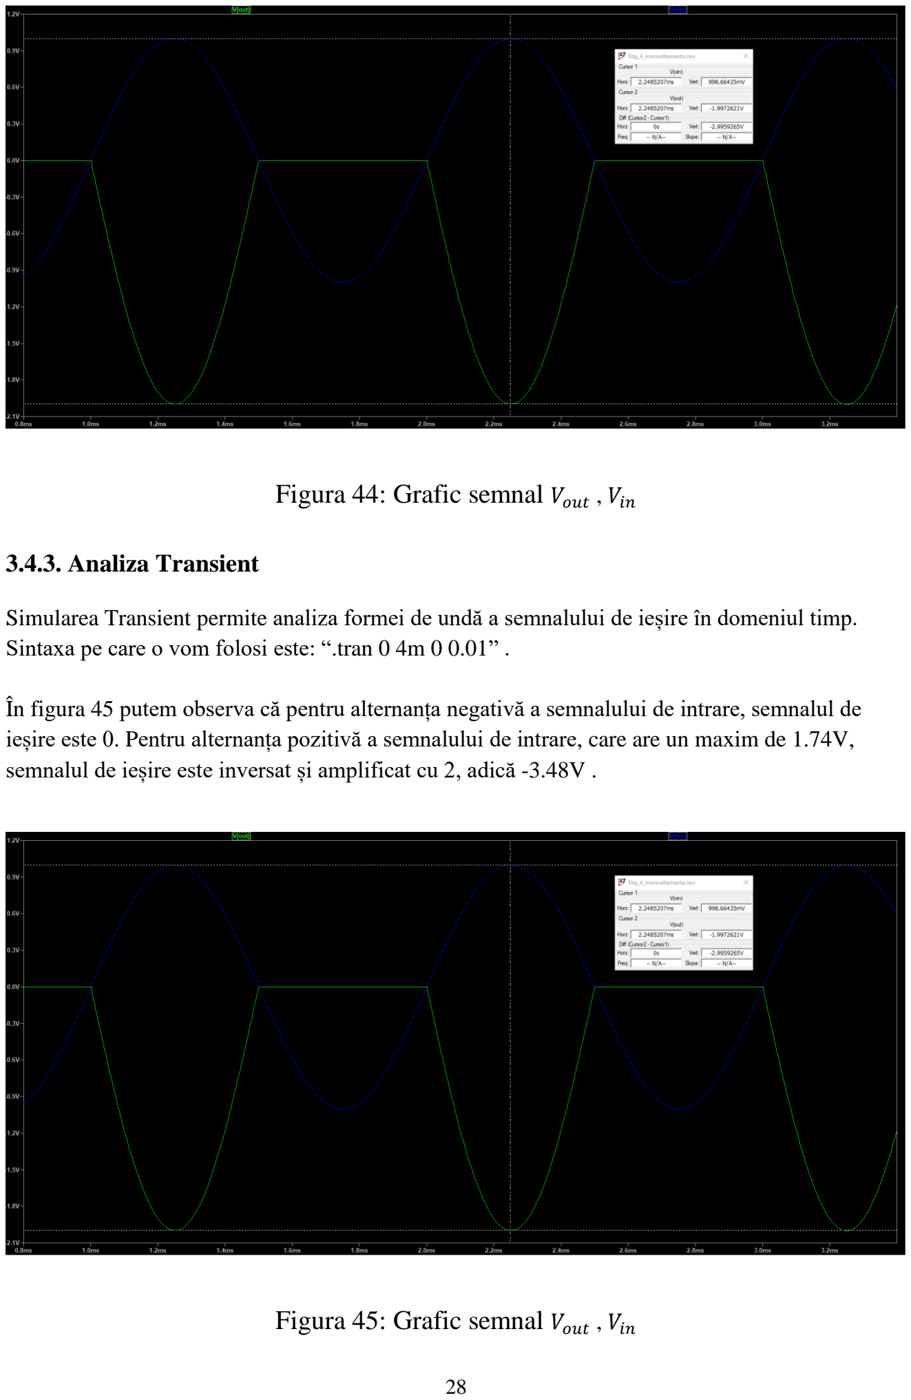
[picture p35: page 28]

### Figura 44: Grafic semnal Vout , Vin

### 3.4.3. Analiza Transient

Simularea Transient permite analiza formei de undă a semnalului de ieșire în domeniul timp. Sintaxa pe care o vom folosi este: “.tran 0 4m 0 0.01” .

În figura 45 putem observa că pentru alternanța negativă a semnalului de intrare, semnalul de ieșire este 0. Pentru alternanța pozitivă a semnalului de intrare, care are un maxim de 1.74V, semnalul de ieșire este inversat și amplificat cu 2, adică -3.48V .

### Figura 45: Grafic semnal Vout , Vin

## 4. Verificarea și caracterizarea interfeței analogice

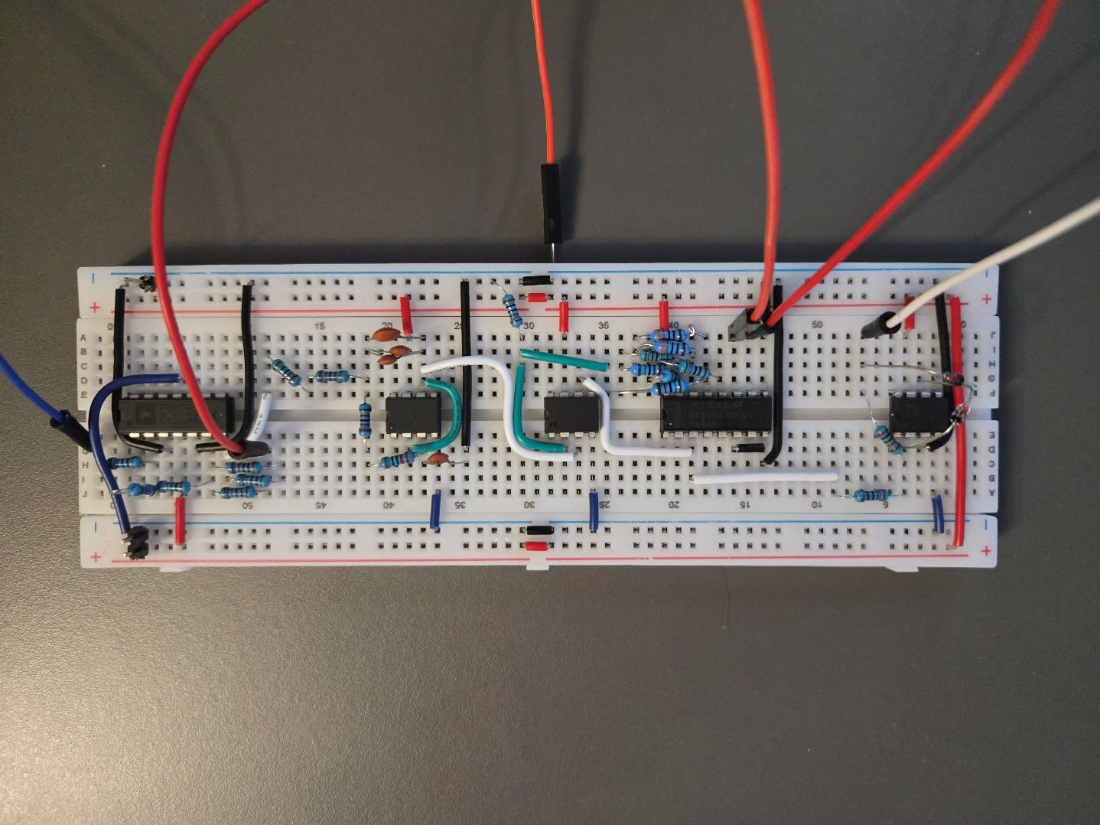
[picture p36: figure]

### Figura 46: Interfața analogică a circuitului

### 4.1. Etajul 1

Pentru realizarea acestui etaj am folosit un amplificator operațional OP482, rezistențe de 10kΩ pentru R1, R2, R3 și R5 iar pentru R4 utilizat o rezistență de 10kΩ în serie cu o rezistență de 20kΩ.

Figura 47 reprezintă diagrama Bode a interfeței analogice a etajului, iar din aceasta putem extrage că banda este de aproximativ 470kHz, valoare mult mai mare decât valoarea benzii filtrului, iar câștigul la joasă frecvență este 9.52dB, adică un câștig liniar de aproximativ 3.

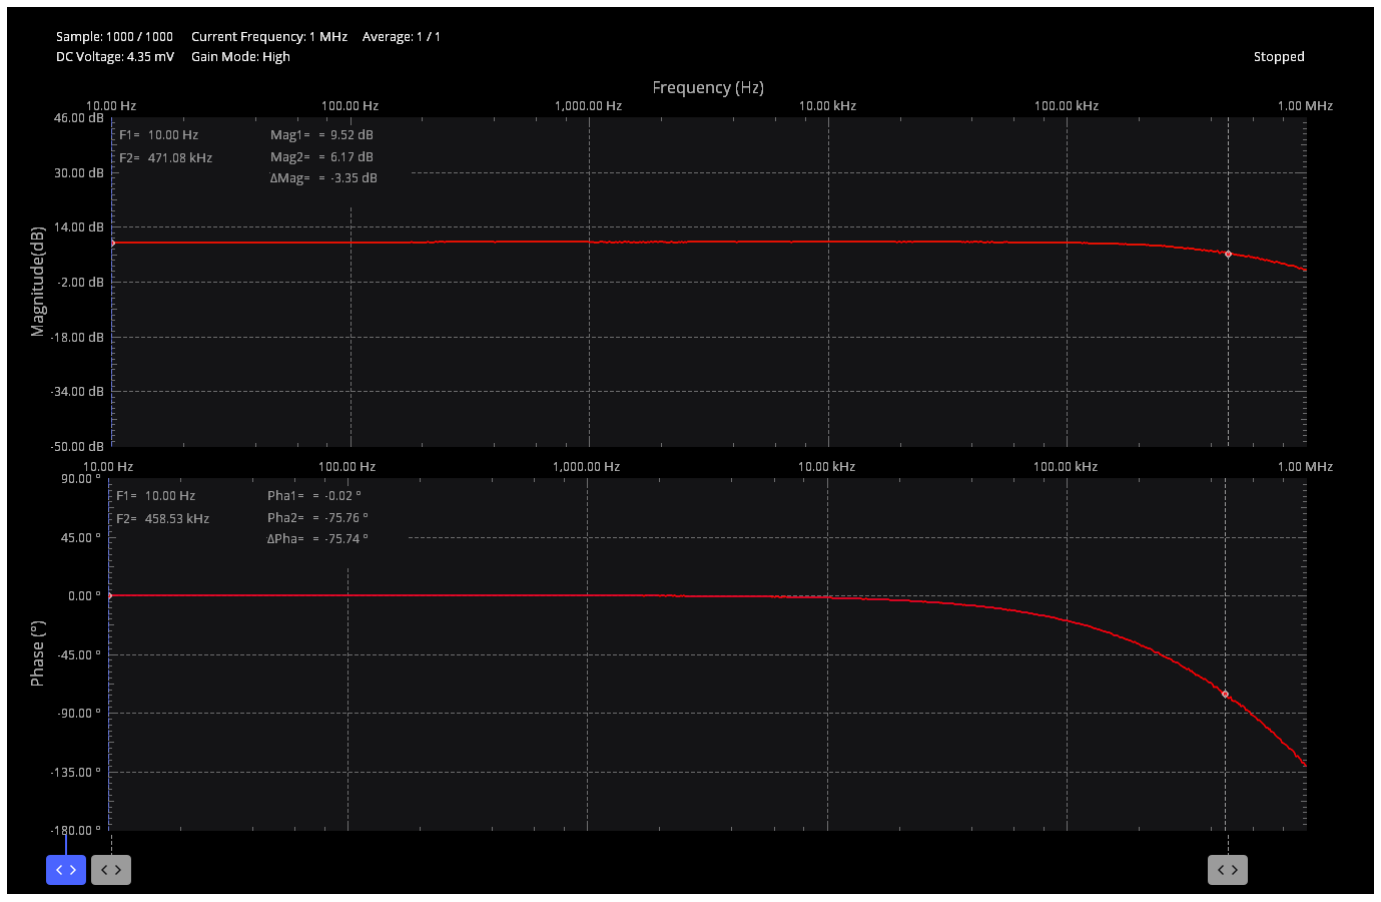
[picture p37: figure]

### Figura 47: Diagrama Bode a etajului 1

Figurile 48 și 49 graficele semnalelor Vout și Vin din care vom deduce SR-ul (slew rate).

Semnalul de intrare are amplitudinea de 1V și frecvența de 10kHz.
Pentru a afla SR-ul vom folosi relația 14 și vom extrage ∆V și ∆t din figura 49.

SR =

∆V
∆t

(14)

După realizarea calculului, ne rezultă SR = 4.56 V
µs

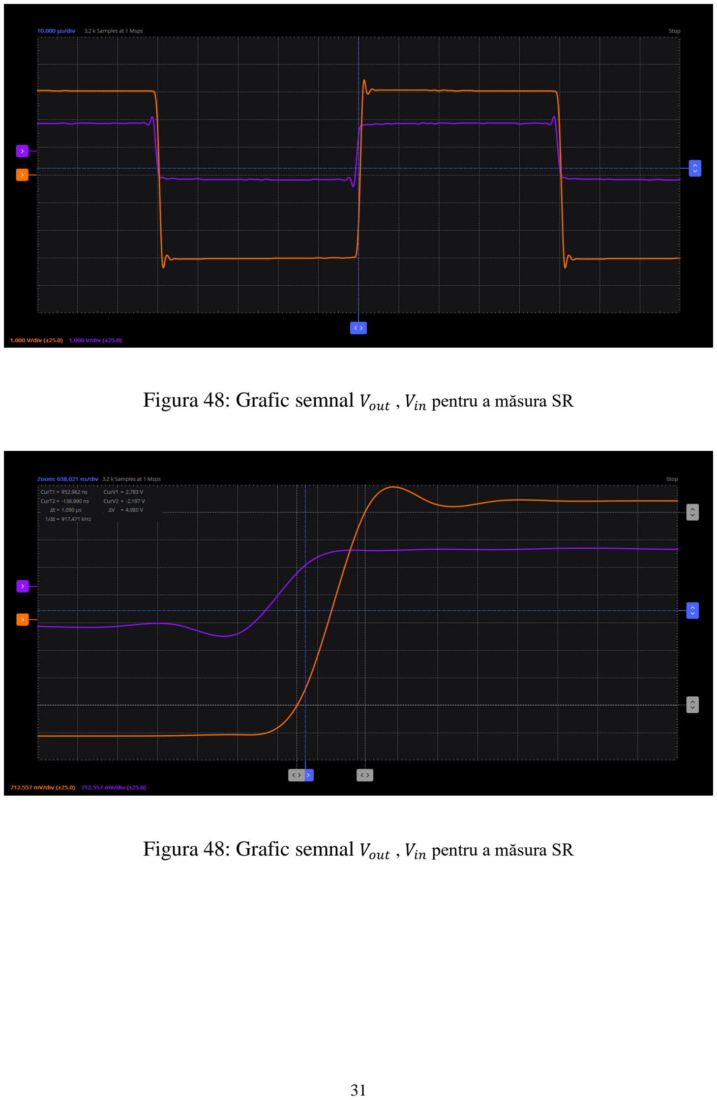
[picture p38: page 31]

### Figura 48: Grafic semnal Vout , Vin pentru a măsura SR

### Figura 48: Grafic semnal Vout , Vin pentru a măsura SR

### 4.2. Etajul 2

Pentru realizarea acestui etaj am folosit un amplificator operațional LT1357, pentru R1 și R2 am folosit rezistențe de 2.2kΩ si 200Ω legate în serie astfel încât să obțin valoarea de 2.42kΩ. Pentru C2 am utilizat un condensator ceramic de 4.7nF, iar pentru C1 am conectat în paralel condensatoare ceramice de 10nF, 6.8nF și 2.2nF, obținând valoare de 19nF.

Figura 49 reprezintă diagrama Bode a interfeței analogice a etajului, iar din aceasta putem extrage că banda este de aproximativ 7.08kHz, iar câștigul la joasă frecvență este 0dB, adică un câștig liniar de 1. Din forma graficului putem deduce că factorul de calitate Q este aproximativ egal cu 0.707 .

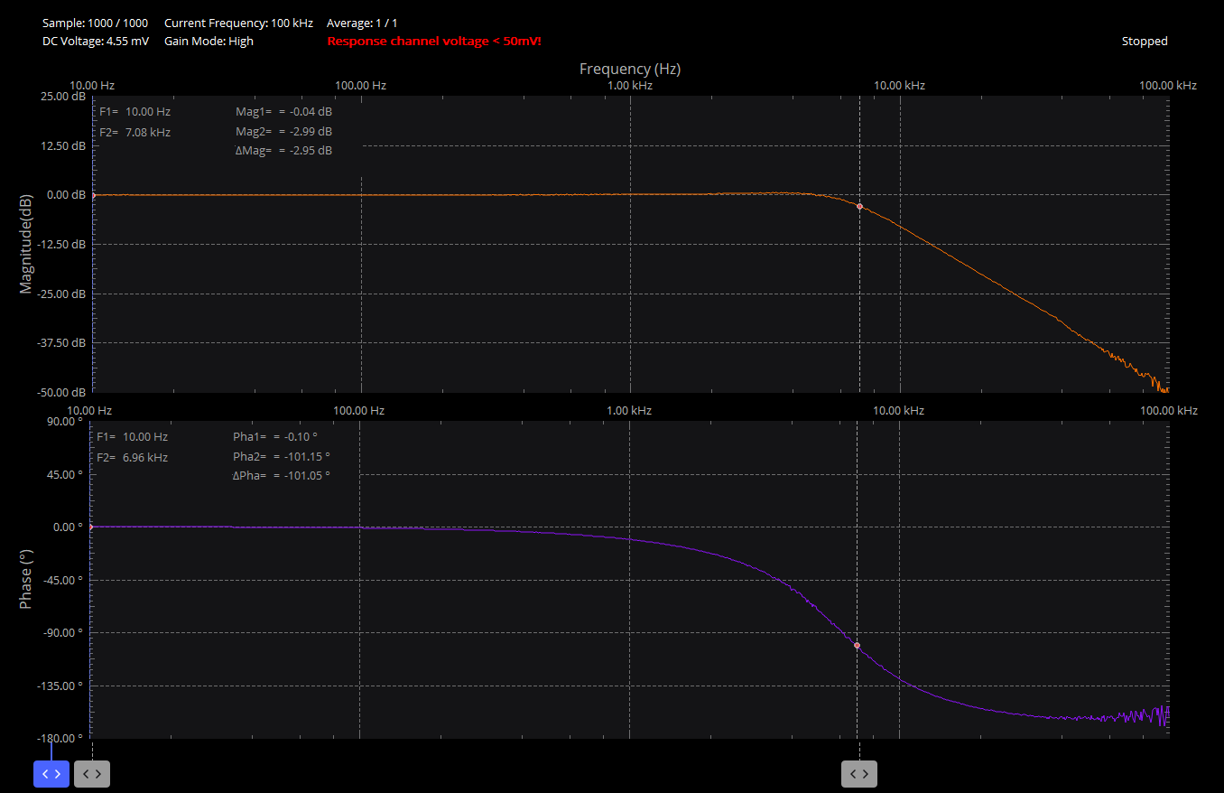
[picture p39: figure]

### Figura 49: Diagrama Bode a etajului 2

### 4.3. Etajul 3

Pentru realizarea acestui etaj am folosit un amplificator operațional LT1357, un multiplexor MAX4617, pentru RG o rezistență de 10kΩ, pentru RF1 o rezistență de 10kΩ conectată în serie cu una de 200Ω, pentru RF2 o rezistență de 6.8kΩ conectată în serie cu una de 1.5kΩ, pentru RF3 două rezistențe de 3.3kΩ conectate în serie, iar pentru RF4 o rezistență de 15kΩ.

Figurile 50, 51, 52 și 53 reprezintă diagramele Bode a interfeței analogice a etajului, pentru fiecare treaptă de câștig.

Pentru Switch 1 ON, obținem un câștig de 13.70dB, iar banda PGA este 4.88MHz. Pentru Switch 2 ON, obținem un câștig de 11.74dB, iar banda PGA este 7.23MHz. Pentru Switch 3 ON, obținem un câștig de 9.84dB, iar banda PGA este 5.23MHz. Pentru Switch 4 ON, obținem un câștig de 7.84dB, iar banda PGA este 6.90MHz.

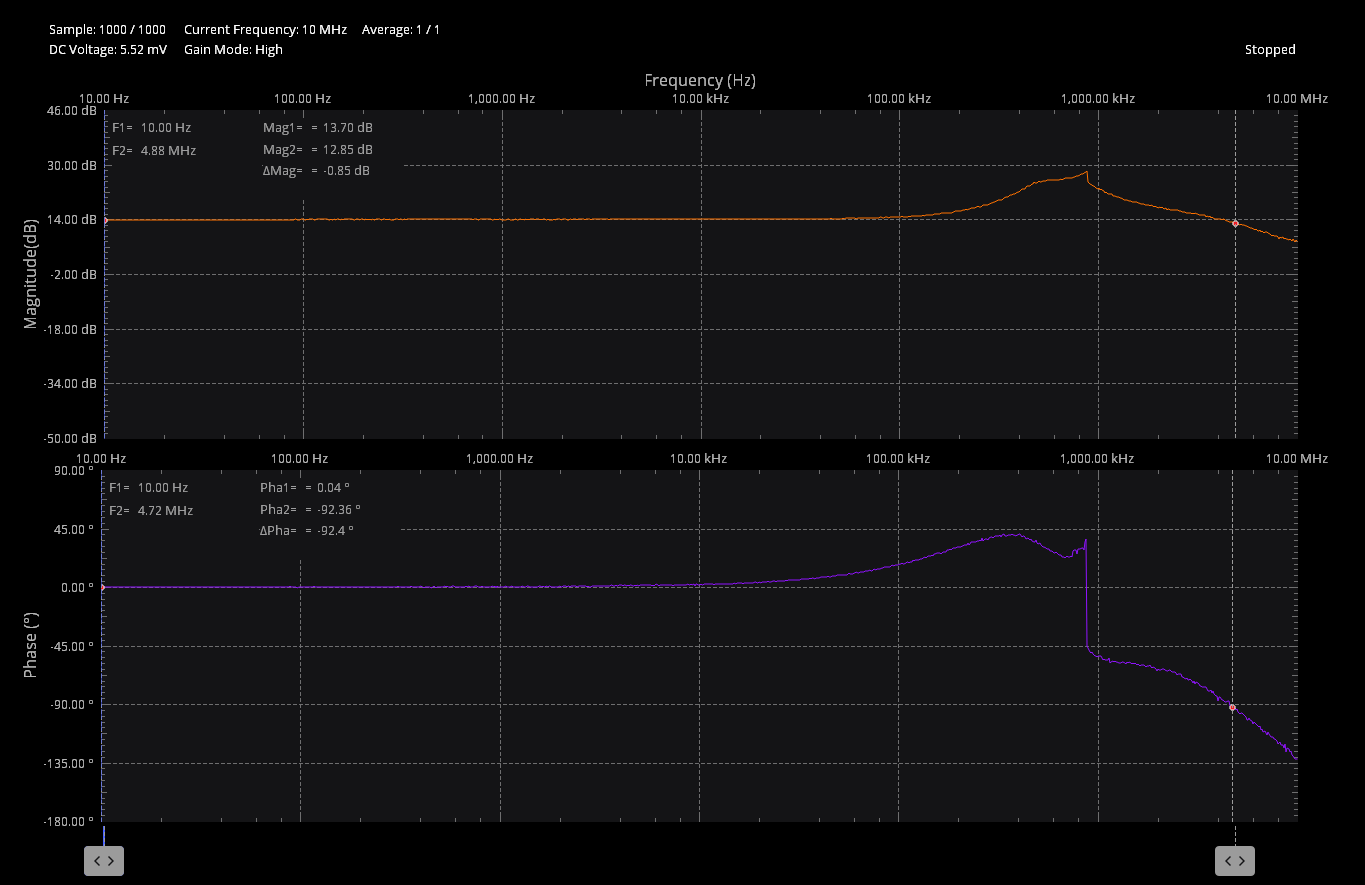
[picture p40: figure]

### Figura 50: Diagrama Bode PGA – Switch 1 ON

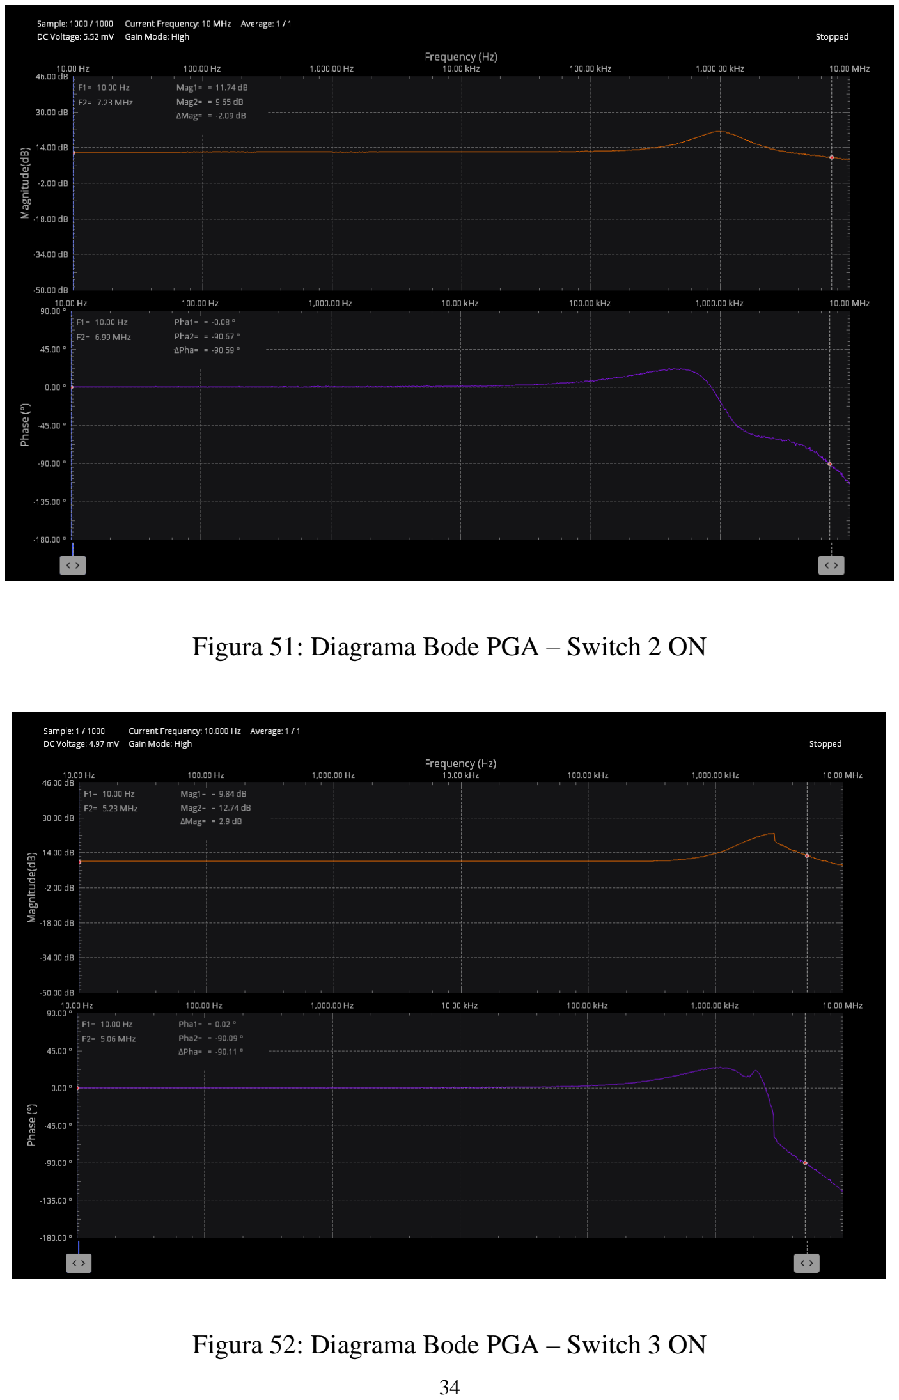
[picture p41: page 34]

### Figura 51: Diagrama Bode PGA – Switch 2 ON

### Figura 52: Diagrama Bode PGA – Switch 3 ON

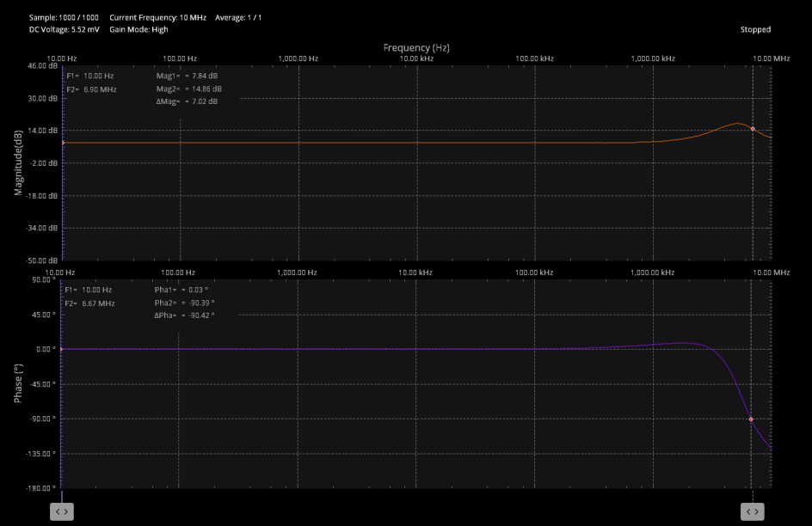
[picture p42: figure]

### Figura 53: Diagrama Bode PGA – Switch 4 ON

### 4.4. Etajul 4

Pentru realizarea acestui etaj am folosit un amplificator operațional AMP03, pentru R1 o rezistență de 10kΩ, pentru R2 o rezistență de 20kΩ, și 2 diode 1N4148.

Figura 54 prezintă implementarea funcției de circuit.
Folosind un semnal de intrare sinusoidal, cu amplitudinea de 1.77V, observăm că pentru alternanța pozitivă semnalul de ieșire are amplitudinea -3.49V, adică este amplificat cu AV = −2, iar pentru alternanța negative semnalul de ieșire este aproximativ 0V.

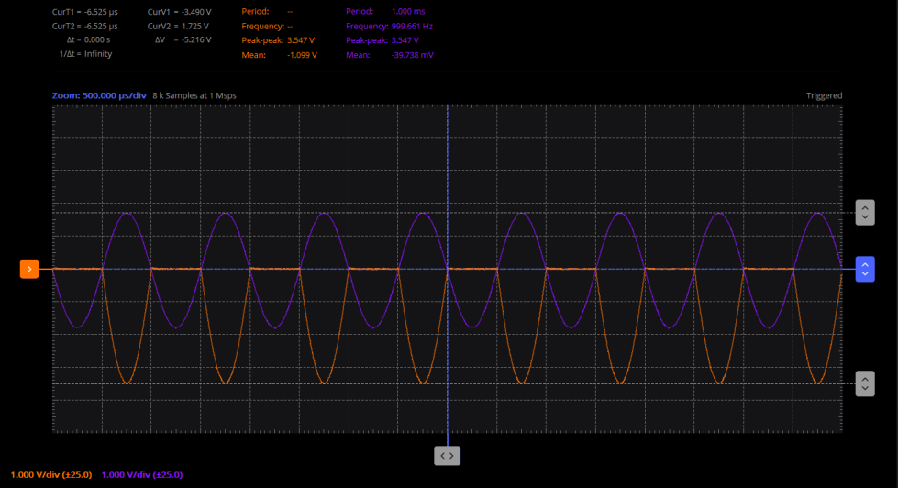
[picture p43: figure]

### Figura 54: Grafic semnal Vout , Vin

## 5. Concluzii

În cadrul acestui proiect, am proiectat, simulat si realizat practic circuitul compus din patru etaje: un amplificator de instrumentație alimentat diferențial, un filtru activ trece-jos, un amplificator cu câștig programabil și un redresor monoalternanță.

### 5.1. Tabel de comparație

În tabelul de mai jos sunt prezentate rezultatele obținute în urma măsurătorilor comparativ cu valorile cerute in specificații.

| Specificații | Măsurători
Câștig etaj 1(liniar) | 3 | 2.99
Câștig etaj 1(dB) | 9.54 dB | 9.52 dB
Câștig liniar în banda de trecere, etaj 2 | 1 | 1
Banda filtrului | 7kHz | 7.08kHz
Factorul de calitate Q | 1 | ≃0.707
Trepte de câștig pentru etaj 3 | 8 dB | 7.84 dB
| 10 dB | 9.84 dB
| 12 dB | 11.74 dB
| 14 dB | 13.70 dB
Câștig etaj 4 | 2 | 1.97

### Tabel 1: Tabel de comparație: specificații vs măsurători

### 5.2. Analiza rezultatelor

Analizând datele din tabel, se constată că circuitul functionează în parametri foarte apropiați de cei proiectați.
Pentru filtrul Sallen-Key se observă o frecvență de tăiere foarte apropiată de cea din specificații, dar factorul de calitate are o eroare de 30%, 0.707 în loc de 1.
Pentru Amplificatorul cu câștig programabil se observă o eroare mică, între 0.16dB și 0.30dB, pentru toate treptele de câștig. Câștigul real este ușor mai mic decât cel teoretic.

### 5.3. Surse și cauze ale erorilor

Diferențele dintre teorie și practică sunt normale și provin din următoarele surse:
- toleranța componentelor pasive: rezistențele utilizate au o toleranță mică, de 1%, dar condensatoarele ceramice pot avea toleranțe de până la 20%, ceea ce poate afecta frecvența de tăiere si factorul de calitate a filtrului activ.
- elemente parazite pe breadboard.

- imperfecțiunea amplificatoarelor operaționale: modelul real al amplificatorului operațional nu are o impedanță de intrare infinită și nici impedanța de ieșire zero, iar produsul câștig-bandă, GBW, este finit.
- erori de măsurare .
