Silviuu24/TUCN-Analog-Circuits-SCIA/LTspice_Simulari/Etaj_1_AI_2AO_inv_AC.asc

E1: e; -0.5
E2: e; -0.5
E3: e; -0.5
E4: e; -0.5
E5: e; -0.5
E6: e; -0.5
R1: res; 10k
R2: res; 10k
R3: res; 10k
R4: res; 30k
R5: res; 10k
R6: res; 10k
R7: res; 10k
R8: res; 10k
R9: res; 30k
R10: res; 10k
R11: res; 10k
R12: res; 10k
R13: res; 10k
R14: res; 30k
R15: res; 10k
U1: LT1679
U2: LT1679
U3: LT1679
U4: LT1679
U5: LT1679
U6: LT1679
V1: voltage; 5
V2: voltage; -5
V3: voltage; 5; AC 1
Vicm1: voltage; SINE(0 0.616 1k); AC 0
Vicm2: voltage; ""; AC 1
Vicm3: voltage; ""; AC 0
Vin1: voltage; SINE(0 0.232 1k); AC 1
Vin2: voltage; ""; AC 0
Vin3: voltage; ""; AC 0
Named nets: 0, +V, -V, outd, outCM, outPS, +V_PS
.ac dec 100 .01 10Meg
.meas AC AD FIND V(outd) AT 1
Measure low-frequency gain (and phase): .meas AC Gain_LowFrequency FIND <Function> AT <Frequency>
.meas AC ACM FIND V(outCM) AT 1
.meas AC CMRR FIND (V(outd)/V(outCM)) AT 1
.meas AC PSRR FIND (V(outd)/V(outPS)) AT 1
.meas AC APS FIND V(outPS) AT 1
.meas AC outd_max MAX mag(V(outd)) ; find the peak response
.meas AC BW FIND v(outd) WHEN mag(v(outd))=outd_max/sqrt(2) FALL=last
.tran 0 10m 0 0.1m
.four 1k V(outd)
