Silviuu24/TUCN-Analog-Circuits-SCIA/LTspice_Simulari/Etaj_1_AI_2AO_inv_op.asc

E1: e; -0.5
E2: e; -0.5
R1: res; 10k
R2: res; 10k
R3: res; 10k
R4: res; 30k
R5: res; 10k
U1: LT1679
U2: LT1679
V1: voltage; 5
V2: voltage; -5
Vicm1: voltage; DC 0
Vin1: voltage; ""; DC 1
Named nets: 0, +V, -V, outd
.op
