Silviuu24/TUCN-Analog-Circuits-SCIA/LTspice_Simulari/Etaj_1_AI_2AO_inv_trans.asc

E1: e; 0.5
E2: e; 0.5
R1: res; 10k
R7: res; 10k
R8: res; 10k
R9: res; 30k
R10: res; 10k
U1: LT1679
U2: LT1679
V1: voltage; 5
V2: voltage; -5
V3: voltage; PULSE(-5 5 1u 10n 10n 50u 100u)
Vicm1: voltage; SINE(0 1 50)
Named nets: +V, -V, OUT, 0, Vid, Vicm
.tran 0 100u 0 10n
