Silviuu24/TUCN-Analog-Circuits-SCIA/LTspice_Simulari/Etaj_2_Filtru_Sallen_Key.asc

C1: cap; 18.8n
C2: cap; 4.7n
R1: res; 2.42k
R2: res; 2.42k
U1: LT1679
V1: voltage; SINE(0 0.696 15k); AC 1
VCC: voltage; 5
VEE: voltage; -5
Named nets: VEE, VCC, 0, out-AC_TJ
.ac oct 100 1 10k
.tran 0 10m 0 0.01m
.four 1k V(out-AC_TJ)
