Silviuu24/TUCN-Analog-Circuits-SCIA/LTspice_Simulari/Etaj_2_Filtru_Sallen_Key_op.asc

C1: cap; 4.7n
C2: cap; 18.8n
R1: res; 2.42k
R2: res; 2.42k
U1: LT1679
V1: voltage; ""; DC 1
VCC1: voltage; 5
VEE1: voltage; -5
Named nets: VEE, VCC, 0, out-AC_TJ
.op
