Silviuu24/TUCN-Analog-Circuits-SCIA/LTspice_Simulari/Etaj_3_PGA.asc

CL: cap; 1p
Rf1: res; 10.2k
Rf2: res; 8.2k
Rf3: res; 6.6k
Rf4: res; 15k
Rg: res; 10k
S1: sw; MySwitch
S2: sw; MySwitch
S3: sw; MySwitch
S6: sw; MySwitch
U1: LT1679
V1: voltage; -5
V2: voltage; 5
V5: voltage; 0
V6: voltage; 0
V7: voltage; 0
V8: voltage; 5
Vin: voltage; SINE(0 696m 1k); AC 1
Named nets: 0, VDD, out, VSS, in, S1, S2, S3, S4
.tran 0 10m 0 0.01m
.model MySwitch SW(Vt=2.5 Ron=1 Roff=100Meg)
.four 1k V(out)
