Silviuu24/TUCN-Analog-Circuits-SCIA/LTspice_Simulari/Etaj_3_PGA_ac.asc

CL2: cap; 1p
Rf1: res; 10.2k
Rf2: res; 15k
Rf3: res; 6.6k
Rf4: res; 8.2k
Rg1: res; 10k
S1: sw; MySwitch
S2: sw; MySwitch
S3: sw; MySwitch
S4: sw; MySwitch
U2: LT1679
V2: voltage; 5
V4: voltage; -5
V8: voltage; {5*u(control==4)}
V9: voltage; {5*u(control==3)}
V10: voltage; {5*u(control==2)}
V11: voltage; {5*u(control==1)}
Vin2: voltage; SINE(0 348m 1k); AC 1
Named nets: 0, S1, S2, S3, S4, VDD, out, VSS, in
.ac dec 100 1 10Meg
.op
;tran 0 1m 0 100n
.FOUR 1khz 10 V(OUT)
.OPTIONS plotwinsize=0
To disable compression
.OPTIONS numdgt=7
To switch to double precision math
on dependent variables
.param control=4
.step param control list 1 2 3 4
.meas AC gain FIND V(Out) AT 1Hz
.option plotwinsize=0 numdgt=15
.param t=0.5
.model MySwitch SW(Vt=2.5 Ron=1 Roff=100Meg)
