Silviuu24/TUCN-Analog-Circuits-SCIA/LTspice_Simulari/Etaj_3_PGA_op.asc

CL1: cap; 1p
Rf1: res; 10.2k
Rf2: res; 15k
Rf3: res; 6.6k
Rf4: res; 8.2k
Rg1: res; 10k
S1: sw; MySwitch
S2: sw; MySwitch
S3: sw; MySwitch
S4: sw; MySwitch
U1: LT1679
V1: voltage; 5
V2: voltage; -5
V3: voltage; 0
V4: voltage; 0
V5: voltage; 0
V6: voltage; 5
Vin1: voltage; 1
Named nets: 0, VDD, out, VSS, in, S1, S2, S3, S4
.op
.model MySwitch SW(Vt=2.5 Ron=1 Roff=100Meg)
.four 1k V(out)
