Silviuu24/TUCN-Analog-Circuits-SCIA/LTspice_Simulari/Etaj_4_monoalternanta.asc

D3: diode; 1N4148
D4: diode; 1N4148
R1: res; 10k
R2: res; 20k
Rl: res; 1k
U1: LT1679
V1: voltage; SINE(0 1.74 1k)
V2: voltage; 5
V3: voltage; -5
Named nets: 0, Out, Vo, V+, V-, Vin
.tran 0 4m 0 0.01
.dc V1 -5 5 0.01
