Silviuu24/TUCN-Analog-Circuits-SCIA/LTspice_Simulari/Etaj_4_monoalternanta_op.asc

D1: diode; 1N4148
D2: diode; 1N4148
R1: res; 10k
R2: res; 20k
Rl1: res; 1k
U1: LT1679
V2: voltage; 5
V3: voltage; -5
V4: voltage; 1
Named nets: 0, Out, Vo, V+, V-, Vin
.op
